adithyasunil26/2-stage-OTA/Report.pdf

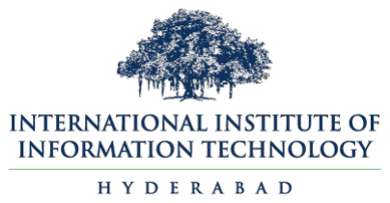
[picture p1: figure]

# ANALOG IC DESIGN

## COURSE PROJECT

## Adithya Sunil Edakkadan

2019102005

# Contents

1 Design Specification | 1
2 Architecture and hand calculations | 2
3 Simulations | 7
4 Layout | 20

5 Design example | 33
6 Results | 37

## CHAPTER 1

# DESIGN SPECIFICATION

### 1.1 DESIGN SPECIFICATIONS

The given design specifications are as follows:

- DC gain ≥ 80 dB
- Unity gain frequency ≥ 10 MHz
- Output voltage swing ≥ 1Vpp
- Slew rate ≥ 100 V/µs
- Phase Margin ≥ 65◦
- Input referred noise (Thermal only) = 10nv/√ Hz
- Input Common mode voltage = 0.9 V
- Output load capacitance = 1 pF
- VDD ≤ 1.8 V
- Minimum power consumption

### 1.2 SPECIFICATION DESCRIPTION

The given specifications require the amplifier to have a large gain of 80 dB or greater, a unity gain frequency greater than or equal to 10 MHz and an output voltage swing of 1 V. The slew rate of the amplifier must be greater than or equal to 100 V/µs and phase margin greater than 65◦
. The input referred
noise due to thermal noise must 10 nV/√
Hz. The input common mode voltage is 0.9 V, output load capacitance is 1 pF and the source voltage is 1.8 V. The specifications also require the power consumption to be minimized while meeting the other requirements.

## CHAPTER 2

# ARCHITECTURE AND HAND

# CALCULATIONS

### 2.1 ARCHITECTURE COMPARISON AND SELECTION

To meet the specifications for high gain, high output swing, minimal power dissipation and low noise performance, a 2 stage op-amp topology is used. The first stage must produce very high gain while the second stage produces high output swing. The telescopic cascode op-amp architecture offers high gain due to the increased output resistance and improved noise performance for lower power consumption. However,the output swing is diminished. The folded-cascode architecture in comparison offers higher swing at the cost of higher power consumption. Hence, the chosen structure for the first stage is the telescopic op-amp as it offers high gain while consuming less power. The second stage is a common source amplifier stage which improves the output swing.

### 2.2 SCHEMATIC

The schematic of the selected architecture is as shown in Fig. 2.1.

### 2.3 DESIGN PROCEDURE AND CALCULATIONS

The transistor parameters are as summarized in Table 2.1. These values are taken from the TSMC 180nm wafer tests sheet found here. (http://www.ee.iitm.ac.in/~nagendra/cadinfo/tsmc018_info.txt)

TABLE 2.1
Table showing design parameters
Parameter | N-Channel | P-Channel
Vth (V) | 0.51 | -0.51
µCox (µA/V ² ) 2 | 175.4 | -35.6

The design process followed is as follows.

VDD = 1.8V

The phase margin is given by Eq. (2.1).

ϕM = ±180◦−Arg[A(jω)F(jω)] = ±180◦−tan⁻¹

ω
|p1|
−tan⁻¹
ω
|p2|
−tan⁻¹
ω
|z1|
(2.1)

CHAPTER 2 – ARCHITECTURE AND HAND CALCULATIONS

M3 | M4
M1 | M2
M5 | M6
M7 | M8 Vdd
M10 | M9

M12

M11

I

ref | CC

RC

Vin- | Vin+ Vb1

Vb2

Vout

FIGURE 2.1
Schematic of the selected 2-stage op-amp structure

Considering the zero is 10 times higher than gain bandwidth and phase margin of 80◦

80◦ = 180◦ − tan⁻¹

[AV (0)] − tan⁻¹

GB
|p2|
− tan⁻¹
(0.1)

For large AV (0) the equation can be simplified to

4.2894◦ = tan⁻¹

GB
|p2|

Solving for |p2| as follows

|p2| =

GB
tan(4.2894◦) = 13.3 · GB

The requirement for Miller capacitance (CC) value for such pole placement is given by Eq. (2.2)

CC >

13.3
10
CL | (2.2)

So the capacitance must be chosen such that

CC > 1.33 pF

CC is selected to be 2pF. The slew rate required is > 100 V /µs. A slew rate of 200 V /µs is selected for the OTA. The tail current I9 is given by Eq. (2.3).

I9 = SR · CC | (2.3)

CHAPTER 2 – ARCHITECTURE AND HAND CALCULATIONS

I9 = 200 × 10⁶ × 2 × 10⁻¹²

I9 = 400 µA

Assuming the output of the telescopic stage is biased at VDD 2 which is 0.9 V the equations for the saturation drain source voltage are as follows.

VSDsat6

+ VSDsat8

= 0.375

VDSsat4

+ VDSsat2

+ VDSsat9

= 0.375

Considering M1, M2, M3 and M4 to be identical and M5, M6, M7 and M8 to be identical

VSDsat5−8

= 0.1875

VDSsat1−4

= 0.1275

The transconductance of a transistor is given by Eq. (2.4).

gm =

2ID

VDSsat

(2.4)

We have

gm1−4 =

400×10⁻⁶
0.1275 = 3.137 mS

gm5−8 =

400×10⁻⁶
0.1875 = 2.133 mS

The relation between gm and ID as given in Eq. (2.5) can be used to find the W
L

of the transistors.

gm =

s
2µCox
W
L
ID | (2.5)

We have
W
L

1−4

= 70.1309 ≈ 71
W
L

5−8

= 159.75 ≈ 160

For M9 the W
L

ratio can be taken as double that of M1 as the current is double.
W
L

9

= 142

For the 2nd stage of the OTA, the design parameters are derives as follows.

gm11 = 1.33
CL
CL
gm1−4 = 2.086 mS
W
L

11

=

W
L

5−8

gm11

gm5−8

= 160
2.086

2.133
= 156.47 ≈ 157

I11 =

g

2m11
2µpCox(
W

L )
11

= 194.63 ≈ 195 µA
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
≈ 70

For cancelling the non-dominant pole using a nulling resistor RC,

RC =

CC +CL
gm11CC

=

1×10⁻¹²+2×10⁻¹²
2.086×10⁻³×2×10⁻¹² = 719.08Ω

CHAPTER 2 – ARCHITECTURE AND HAND CALCULATIONS

Now, the specifications of the designed amplifier can be calculated. The gain of the 2 stage structure will the product of the individual stages.

Av = Av1Av2

For finding the gain of the telescopic cascode stage, gds of a transistor is given by Eq. (2.6).

gds = λID | (2.6)

The λN and λP can be experimentally found to be 0.018 V

−1
and 0.015 V

−1
| . The gds and respective rds
values are as follows.

gds1−4 = λN ID1−4 = 0.018 × 200 × 10⁻⁶ = 3.6 µS

rds1−4 =

1
gds1−4

= 277.78 kΩ

gds5−8 = λN ID5−8 = 0.015 × 200 × 10⁻⁶ = 3 µS

rds5−8 =

1
gds5−8

= 333.33 kΩ

The output resistance of the stage rout is given by

rout = ru||rd

rd = gm1−4

r

2
ds1−4

= 236.9 MΩ

ru = gm5−8

r

2
ds5−8

= 242.1 MΩ

rout = 119.7 MΩ

The DC gain of the telescopic stage is as follows.

Av1 = gm1
rout = 375499

Similarly, the gain of the common source stage is given by

Av2 =

gm11

ID11 (λN +λP )

gm11 = 13.3 · gm1−4

CL
CC

Av2 =

gm11
ID11 (λN +λP ) ≈ 324

Hence, the overall gain (Av = Av1Av2
) is well over 100dB.

The gain bandwidth can be calculated as follows

UGB =

gm1
Cc

= 1.57 GHz

The power consumption of the OTA is given by

P = ItotVDD

where Itot will be given by

Itot = I9 + I11

P = (I9 + I11) · VDD = (400µ + 195µ) · 1.8 = 1.071 mA

CHAPTER 2 – ARCHITECTURE AND HAND CALCULATIONS

### 2.4 TABULATING CALCULATED VALUE OF DESIGN PARAMETERS

Table 2.2 shows the design parameters derived in the previous section.

TABLE 2.2
Table showing design parameters
Parameter | Calculated value
W L 1−4 | 71
W L 5−8 | 160
W L 9 | 142
W L 10 | 142
W L 11 | 157
W L 12 | 70
CC (pF) | 2
RC (kΩ) | 0.719

### 2.5 TABULATING CALCULATED SPECIFICATIONS

Table 2.2 shows the calculated specifications as per the design parameters derived in the previous sections.

TABLE 2.3
Table showing calculated specifications
Specification | Calculated Value
DC gain (dB) | >100
Unity gain bandwidth (GHz) | 1.57
Phase margin | 80◦
Slew rate (V /µs) | 200
Power (mW) | 1.071

## CHAPTER 3

# SIMULATIONS

### 3.1 NETLIST

The netlist for the designed 2 stage OTA is as follows.

* T e l e s c o p i c
. i n c l u d e TSMC_180nm . t x t

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

. param width_1234 ={0.36*71 u} . param width_5678 ={0.36*160 u} . param width_910 ={0.36*142 u} . param width_11 ={0.36*157 u} . param width_12 ={0.36*70 u}

. g l o b a l gnd vdd

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

* T r a n s i e n t and AC
vi np i n p gnd dc 0 . 9 ac 0 . 0 1m s i n ( 0 . 9 0 . 0 1m 10k 0 0 0) vi nn i n n gnd dc 0 . 9 ac −0.01m s i n ( 0 . 9 −0.01m 10k 0 0 0)

* Slew Rate
* vi np i n p gnd p u l s e ( 1 . 8 0 −1n 100 p 100 p 500 n 1u )

* O f f s e t
* vi np i n p gnd 0 . 9

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

* 1 s t s t a g e t e l e s c o p i c s t r u c t u r e ( T r a n s i s t o r s a r e named as p e r t h e s c h e m a t i c diagram shown i n r e p o r t )
M1 | d1 | i n n | d9 | gnd | CMOSN | W={ width_1234 } | L={ l e n g t h }
+ AS={5* width_1234 *LAMBDA} PS={10*LAMBDA+2* width_1234 } AD={5* width_1234 *LAMBDA} PD={10*LAMBDA+2* width_1234 }
M2 | d2 | i n p | d9 | gnd | CMOSN | W={ width_1234 } | L={ l e n g t h }
+ AS={5* width_1234 *LAMBDA} PS={10*LAMBDA+2* width_1234 } AD={5* width_1234 *LAMBDA} PD={10*LAMBDA+2* width_1234 }
M3 | d3 | b1 | d1 | gnd | CMOSN | W={ width_1234 } | L={ l e n g t h }
+ AS={5* width_1234 *LAMBDA} PS={10*LAMBDA+2* width_1234 } AD={5* width_1234 *LAMBDA} PD={10*LAMBDA+2* width_1234 }
M4 | d4 | b1 | d2 | gnd | CMOSN | W={ width_1234 } | L={ l e n g t h }
+ AS={5* width_1234 *LAMBDA} PS={10*LAMBDA+2* width_1234 } AD={5* width_1234 *LAMBDA} PD={10*LAMBDA+2* width_1234 }
M5 | d3 | b2 | d5 | vdd | CMOSP | W={ width_5678 } | L={ l e n g t h }
+ AS={5* width_5678 *LAMBDA} PS={10*LAMBDA+2* width_5678 } AD={5* width_5678 *LAMBDA} PD={10*LAMBDA+2* width_5678 }
M6 | d4 | b2 | d6 | vdd | CMOSP | W={ width_5678 } | L={ l e n g t h }
+ AS={5* width_5678 *LAMBDA} PS={10*LAMBDA+2* width_5678 } AD={5* width_5678 *LAMBDA} PD={10*LAMBDA+2* width_5678 }
M7 | d5 | d3 | vdd | vdd | CMOSP | W={ width_5678 } | L={ l e n g t h }
+ AS={5* width_5678 *LAMBDA} PS={10*LAMBDA+2* width_5678 } AD={5* width_5678 *LAMBDA} PD={10*LAMBDA+2* width_5678 }
M8 | d6 | d3 | vdd | vdd | CMOSP | W={ width_5678 } | L={ l e n g t h }
+ AS={5* width_5678 *LAMBDA} PS={10*LAMBDA+2* width_5678 } AD={5* width_5678 *LAMBDA} PD={10*LAMBDA+2* width_5678 }

* 2nd s t a g e common s o u r c e s t r u c t u r e
M9 | d9 | r e f | gnd | gnd | CMOSN | W={ width_910 } | L={ l e n g t h }
+ AS={5* width_910 *LAMBDA} PS={10*LAMBDA+2* width_910 } AD={5* width_910 *LAMBDA} PD={10*LAMBDA+2* width_910 }
M10 | r e f | r e f | gnd | gnd | CMOSN | W={ width_910 } | L={ l e n g t h }
+ AS={5* width_910 *LAMBDA} PS={10*LAMBDA+2* width_910 } AD={5* width_910 *LAMBDA} PD={10*LAMBDA+2* width_910 }

CHAPTER 3 – SIMULATIONS

M11 | o u t | d4 | vdd | vdd | CMOSP | W={ width_11 } | L={ l e n g t h }
+ AS={5* width_11 *LAMBDA} PS={10*LAMBDA+2* width_11 } AD={5* width_11 *LAMBDA} PD={10*LAMBDA+2* width_11 }
M12 | o u t | r e f | gnd | gnd | CMOSN | W={ width_12 } | L={ l e n g t h }
+ AS={5* width_12 *LAMBDA} PS={10*LAMBDA+2* width_12 } AD={5* width_12 *LAMBDA} PD={10*LAMBDA+2* width_12 }

* A n a l y s i s
* . t r a n 1u 1m
* . ac dec 10 1 500Meg
. n o i s e v ( o u t ) vin p dec 100 1 500MEG

. c o n t r o l
run

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

* P l o t s

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

* Gain magnitude and phase
* p l o t ( v ( o u t ) ) / ( v ( i n p ) − v ( i n n ) )
* p l o t 180 / PI * phase ( v ( o u t ) / ( v ( i n p ) − v ( i n n ) ) )
* p l o t ( db ( v ( o u t )) − db ( v ( i n p ) − v ( i n n ) ) ) 18 0/ PI * phase ( v ( o u t ) / ( v ( i n p ) − v ( i n n ) ) )

. endc

### 3.2 TABULATING DESIGN PARAMETERS

Table 6.2 shows the calculated value of design parameters alongside the values used in simulation.

TABLE 3.1
Table showing design parameters
Parameter | Calculated Value | Simulated Value
W L 1−4 | 71 | 71
W L 5−8 | 160 | 160
W L 9 | 142 | 142
W L 10 | 142 | 142
W L 11 | 157 | 157
W L 12 | 70 | 70
CC (pF) | 2 | 2
RC (kΩ) | 0.719 | 1
Iref (µA) | 400 | 400

CHAPTER 3 – SIMULATIONS

### 3.3 OPERATING POINT

The DC operating point analysis is run with the OTA in unity gain feedback mode. Fig. 3.1 shows the results obtained and Fig. 3.2 shows the schematic for the OTA in unity gain feedback mode with labelled nodes.

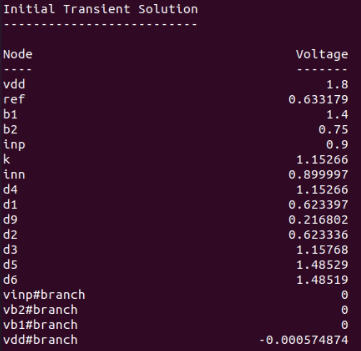
[picture p2: figure]

FIGURE 3.1
DC operating points

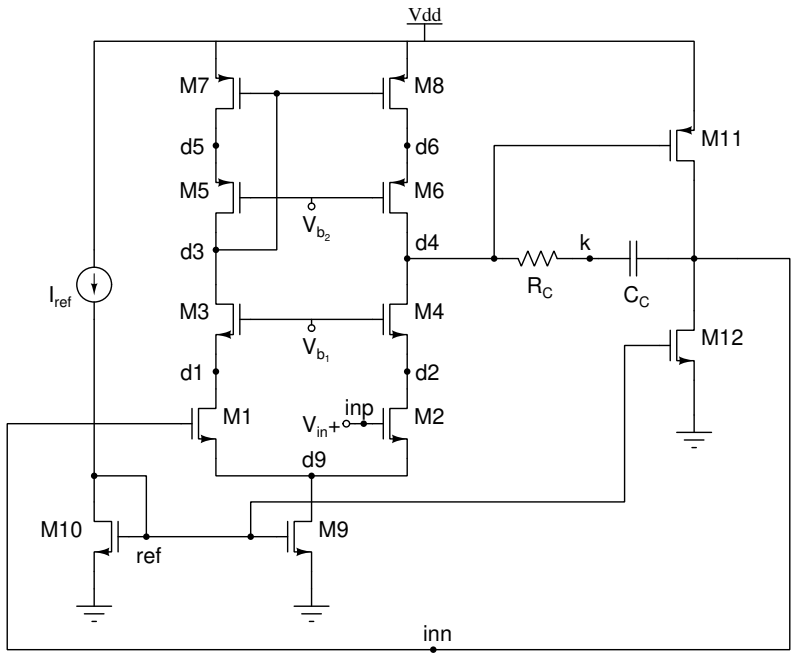
[picture p3: figure]
Vdd; ref; Vin+; inn; inp

FIGURE 3.2
Schematic for unity gain configuration with labelled nodes

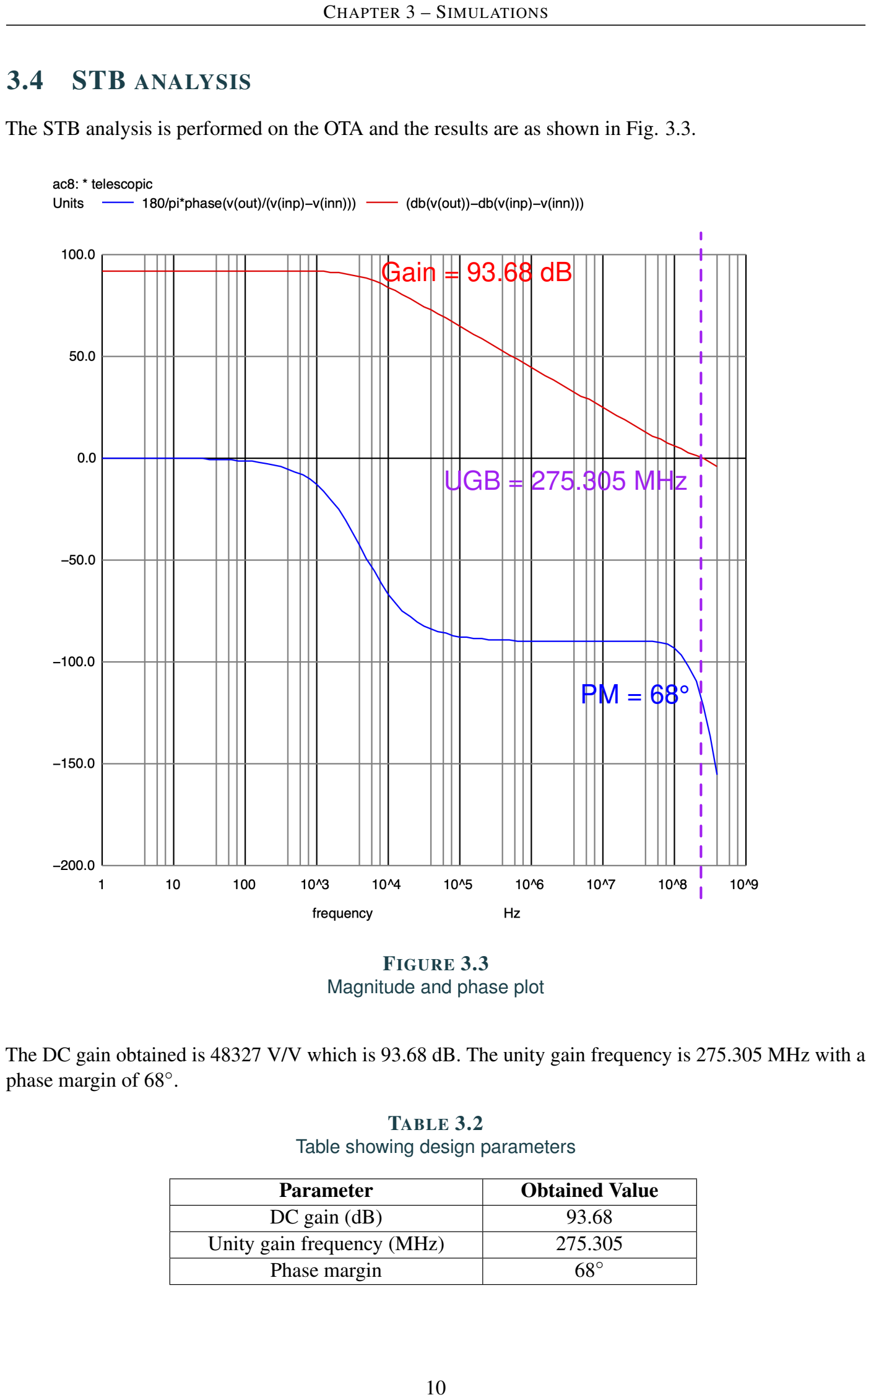
[picture p4: page 13]

CHAPTER 3 – SIMULATIONS

### 3.4 STB ANALYSIS

The STB analysis is performed on the OTA and the results are as shown in Fig. 3.3.

UGB = 275.305 MHz

Gain = 93.68 dB

PM = 68°

FIGURE 3.3
Magnitude and phase plot

The DC gain obtained is 48327 V/V which is 93.68 dB. The unity gain frequency is 275.305 MHz with a phase margin of 68◦

TABLE 3.2
Table showing design parameters
Parameter | Obtained Value
DC gain (dB) | 93.68
Unity gain frequency (MHz) | 275.305
Phase margin | 68◦

CHAPTER 3 – SIMULATIONS

### 3.5 SLEW RATE

With the OTA in unity gain feedback mode, a positive step from 0 to 1.8V with a rise time of 100ps is applied. Fig. 3.4 shows the slewing region.

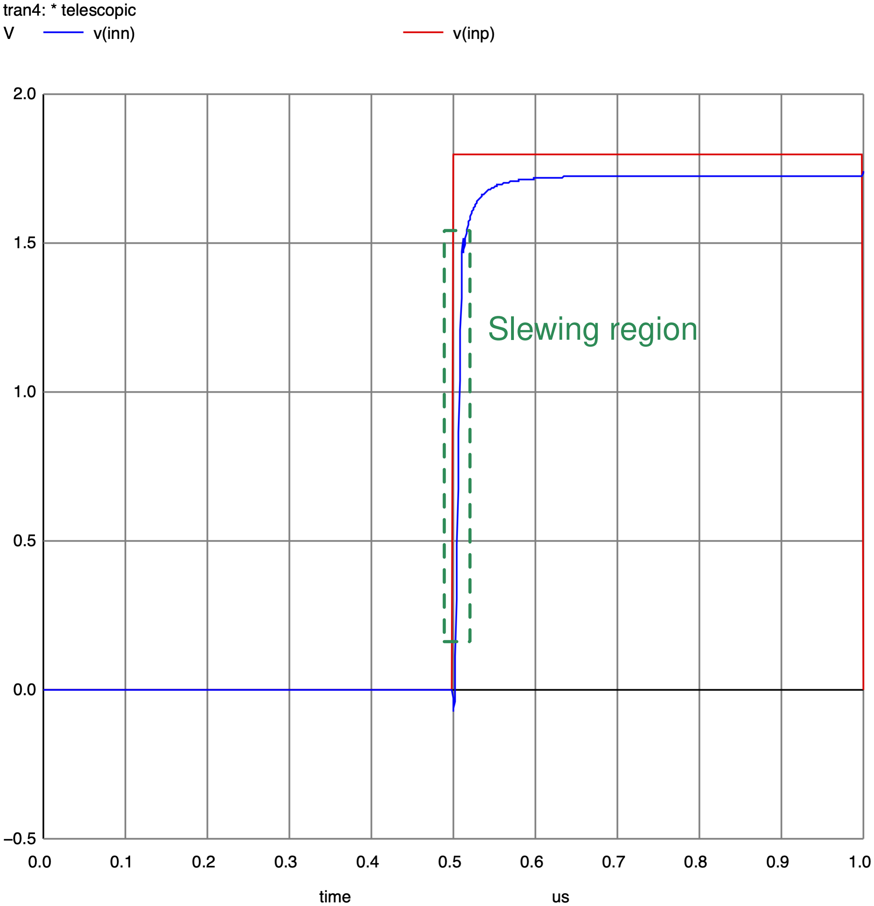
[picture p5: figure]
Slewing region

FIGURE 3.4
Plot showing slewing

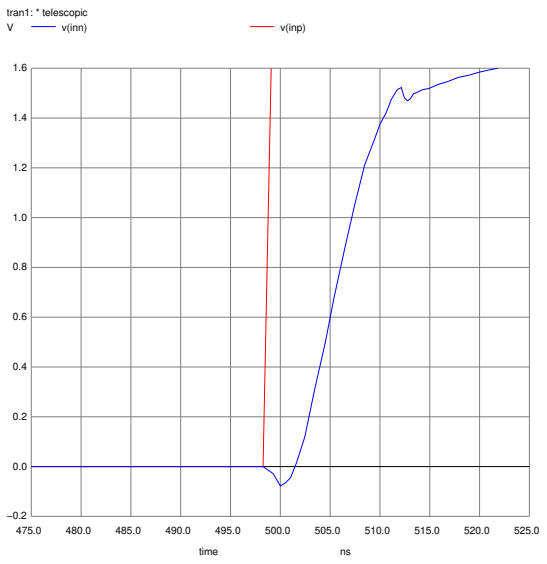
[picture p6: figure]
time; tran1: * telescopic; v(inn); v(inp)

FIGURE 3.5
Plot showing slewing

From zoomed in version of plot shown in Fig. 3.5, the following values of points are obtained of the highest slope region.

x0 = 5.08435e-07, y0 = 1.2

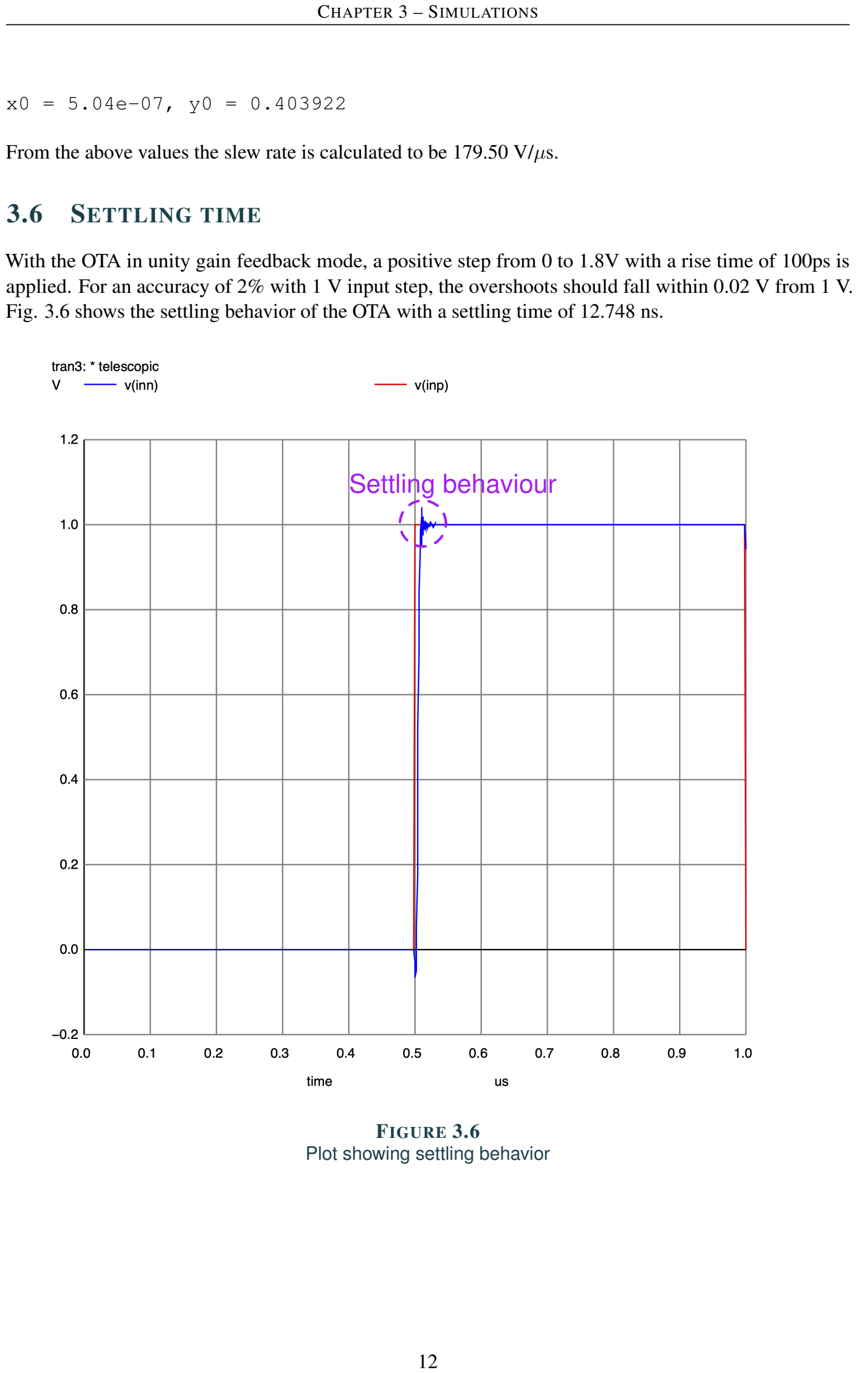
[picture p7: page 15]

CHAPTER 3 – SIMULATIONS

x0 = 5.04e-07, y0 = 0.403922

From the above values the slew rate is calculated to be 179.50 V/µs.

### 3.6 SETTLING TIME

With the OTA in unity gain feedback mode, a positive step from 0 to 1.8V with a rise time of 100ps is applied. For an accuracy of 2% with 1 V input step, the overshoots should fall within 0.02 V from 1 V. Fig. 3.6 shows the settling behavior of the OTA with a settling time of 12.748 ns.

## Settling behaviour

FIGURE 3.6
Plot showing settling behavior

CHAPTER 3 – SIMULATIONS

### 3.7 SYSTEMATIC OFFSET

With the OTA in unity gain feedback mode, the systematic offset value is measured and reported using dc analysis. Fig. 3.7 shows the node voltage on the schematic and the offset of 3.45 µV.

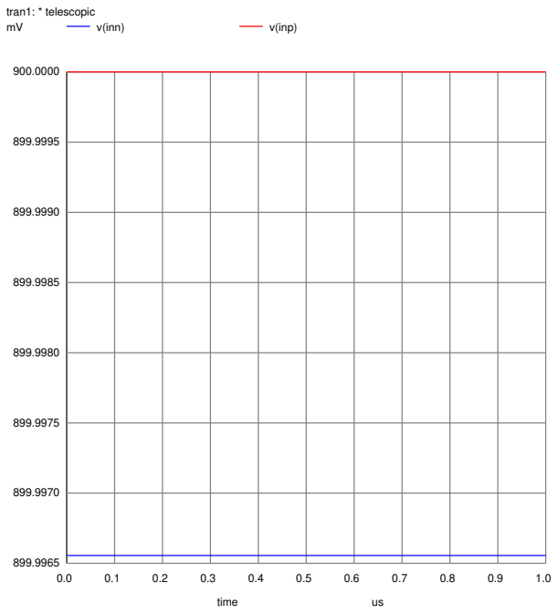
[picture p8: figure]
time; tran1: * telescopic; v(inn); v(inp)

FIGURE 3.7
Plot showing systemic offset

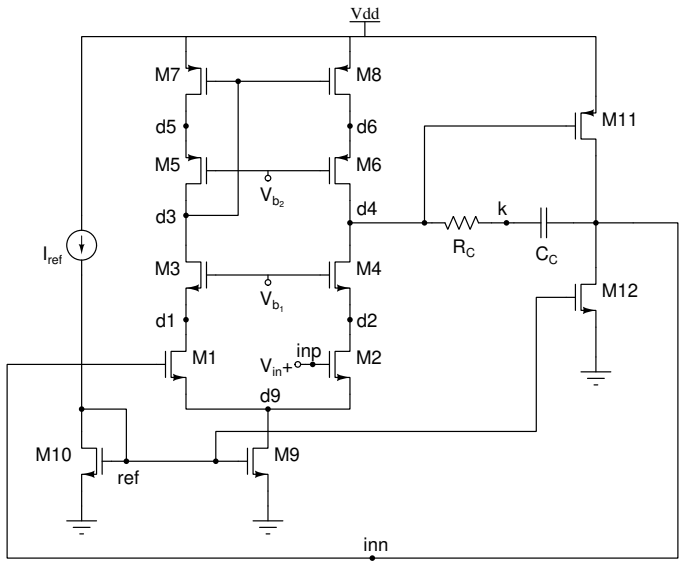
[picture p9: figure]
Vdd; ref; Vin+; inn; inp

FIGURE 3.8
Schematic for unity gain configuration with labelled nodes

## 3.8 NOISE

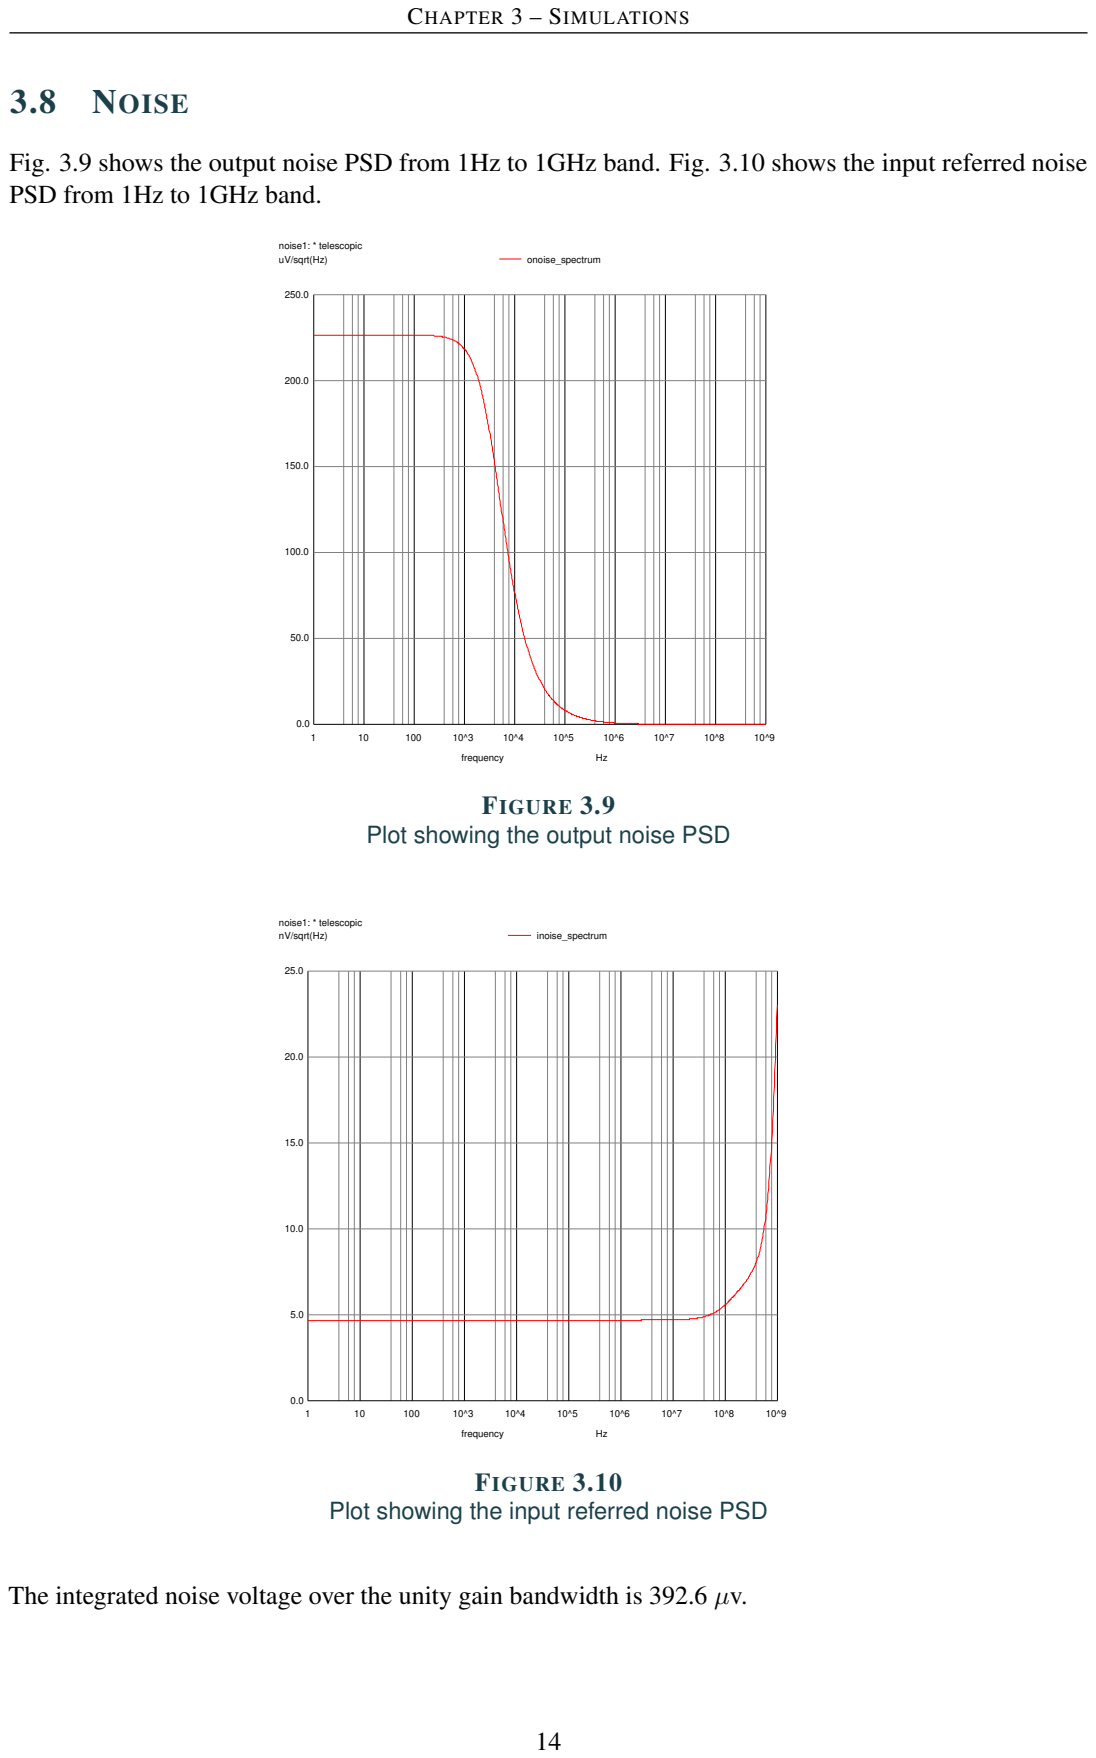
[picture p10: page 17]
CHAPTER 3 – SIMULATIONS; frequency; noise1: * telescopic; uV/sqrt(Hz); onoise_spectrum; FIGURE 3.9; nV/sqrt(Hz); inoise_spectrum; FIGURE 3.10

Fig. 3.9 shows the output noise PSD from 1Hz to 1GHz band. Fig. 3.10 shows the input referred noise
PSD from 1Hz to 1GHz band.

Plot showing the output noise PSD

Plot showing the input referred noise PSD

The integrated noise voltage over the unity gain bandwidth is 392.6 µv.

CHAPTER 3 – SIMULATIONS

## 3.9 CMRR

Common mode rejection ratio (CMRR) quantifies the ability of the device to reject common-mode signals. Fig. 3.11 shows the open loop CM gain of the OTA.

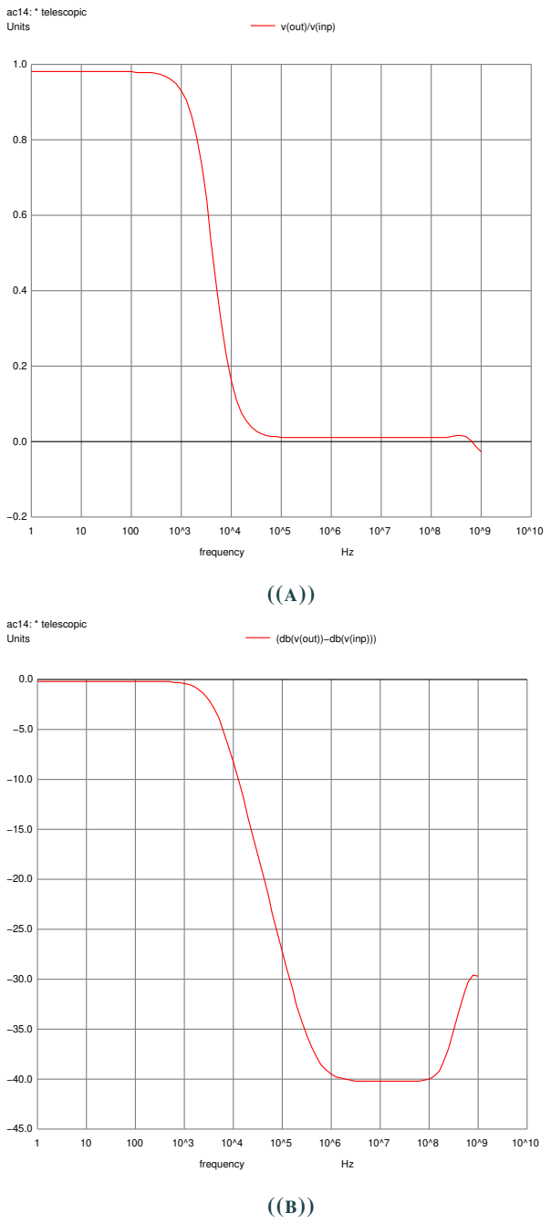
[picture p11: figure]
frequency; ac14: * telescopic; Units; v(out)/v(inp); (db(v(out))−db(v(inp)))

FIGURE 3.11
Common mode gain: (a) V/V and (b) dB

The CM gain (ACM) of the OTA is found to be 0.98 V/V. The differential gain (Ad) of the device is 40017

CHAPTER 3 – SIMULATIONS

V/V. Hence, the CMRR of the OTA is given by Ad
ACM

which is equal to 40833.7 which is equivalent to 92.22 dB.

## 3.10 PSRR

The power supply rejection ratio (PSRR) is used to quantify the ability of the device to reject variations in power supply. The PSRR simulation is performed by adding a small signal component only on the voltage supply of the OTA. Fig. 3.12 shows the results obtained.

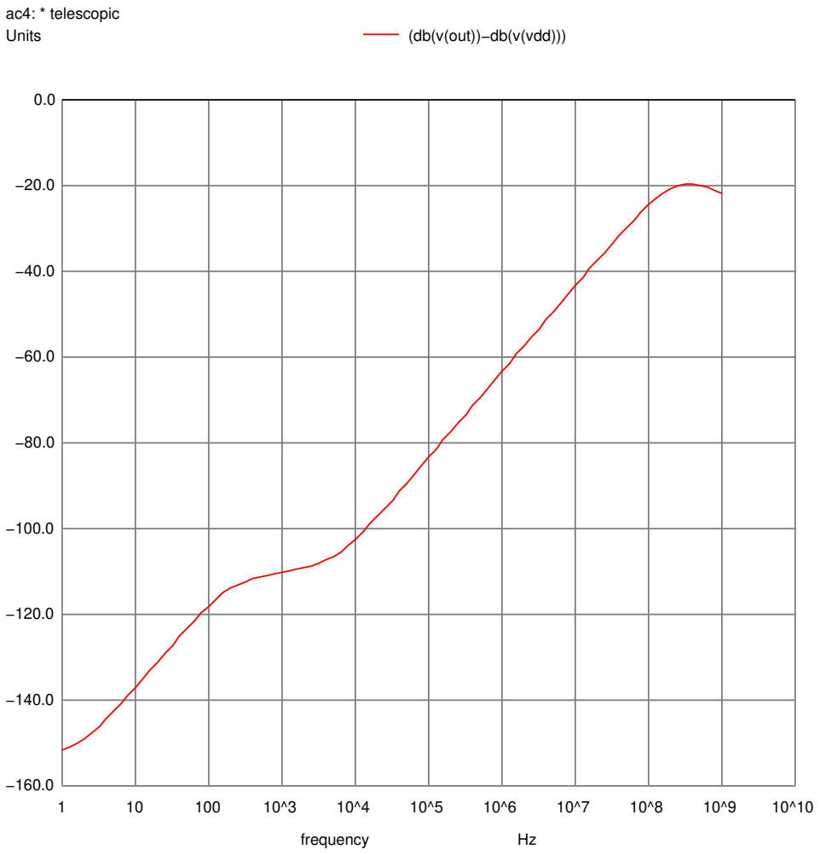
[picture p12: figure]
frequency; ac4: * telescopic; Units; (db(v(out))−db(v(vdd)))

FIGURE 3.12
Gain due to power supply

The PSRR of the OTA is -151.8 dB which means the OTA highly diminishes changes in supply voltage and hence, is resilient to variations in power supply.

CHAPTER 3 – SIMULATIONS

### 3.11 INPUT COMMON MODE RANGE

The input common mode voltage is sweeped in the unity gain configuration. Fig. 3.13 shows the results

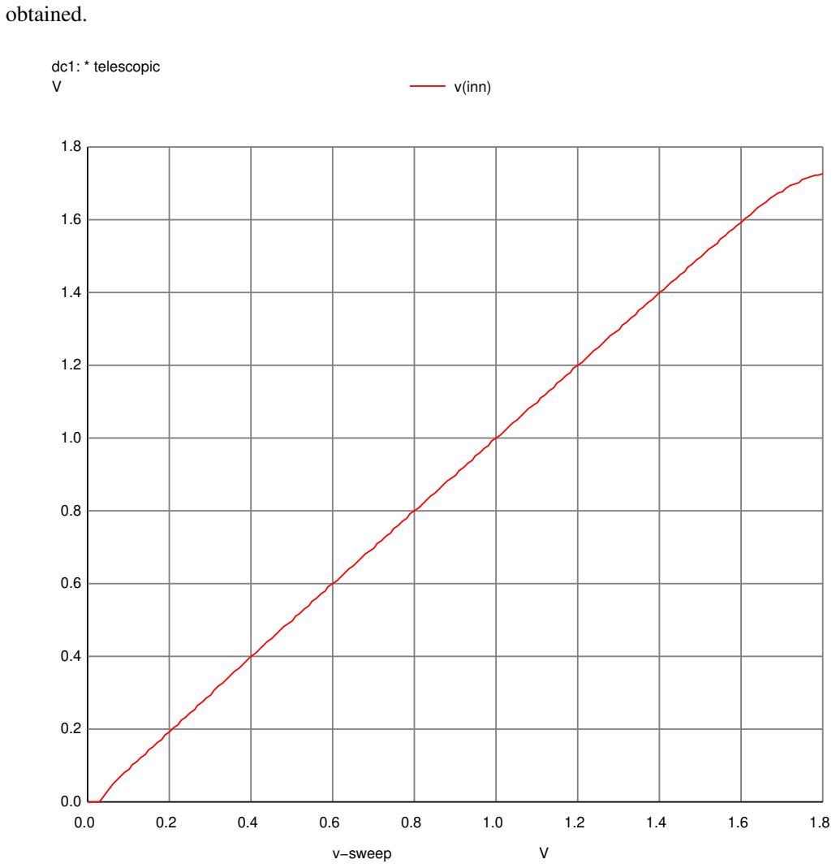
[picture p13: figure]
obtained.; v−sweep; dc1: * telescopic; v(inn)

FIGURE 3.13
Variation of output voltage with input common mode voltage

The maximum input common mode range is 0.4 V - 1.45 V.

CHAPTER 3 – SIMULATIONS

### 3.12 CLOSED LOOP GAIN

With the OTA in unity gain feedback mode, ac analysis is performed. Fig. 3.14 shows the results obtained.

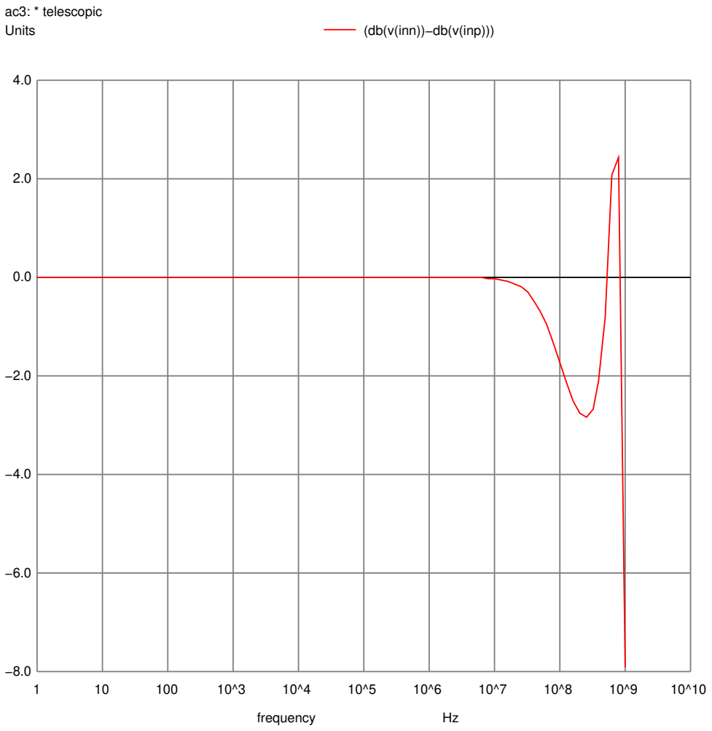
[picture p14: figure]
frequency; ac3: * telescopic; Units; (db(v(inn))−db(v(inp)))

FIGURE 3.14
Closed loop gain

The closed loop gain is 0dB or 1 V/V with a -3dB frequency of 0.899 GHz.

CHAPTER 3 – SIMULATIONS

### 3.13 CLOSED LOOP TRANSIENT ANALYSIS

With the OTA in unity gain feedback mode, a sinusoidal signal of 10KHz frequency is applied for maximum signal swing at the output without distortion Fig. 3.15 shows the results obtained.

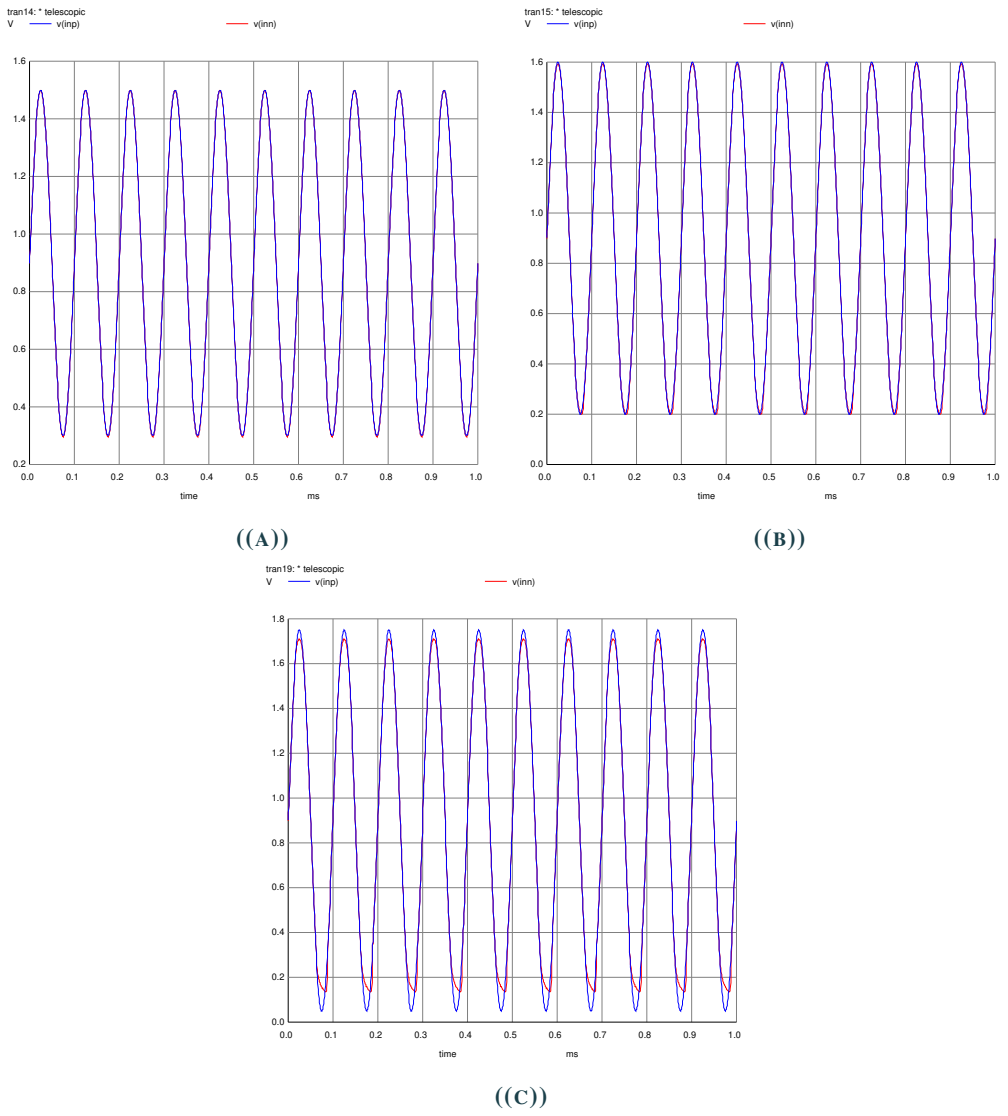
[picture p15: figure]
time; tran14: * telescopic; v(inp); v(inn); tran15: * telescopic; tran19: * telescopic

FIGURE 3.15
Closed loop transient analysis plots: (a) Output swing of 1.2 V, (b) Output swing of 1.4 V and (c) Output swing of 1.7 V

Output swing of 1.2 V can be obtained with THD less than 0.3% while a swing of 1.4 V increases the THD to 1.2%. Output swing of upto 1.7 V can be obtained with a THD of 5.5%.

### 3.14 POWER CONSUMPTION

The average value of current drawn by the OTA from supply in simulation is 569.129 µA and the total power consumption is 1.024 mW.

## CHAPTER 4

# LAYOUT

### 4.1 LAYOUT

The proposed OTA has been implemented in 180nm CMOS technology and occupies an area of 65.16 µm × 23.58 µm. Fig. 4.1 shows the layout of the OTA.

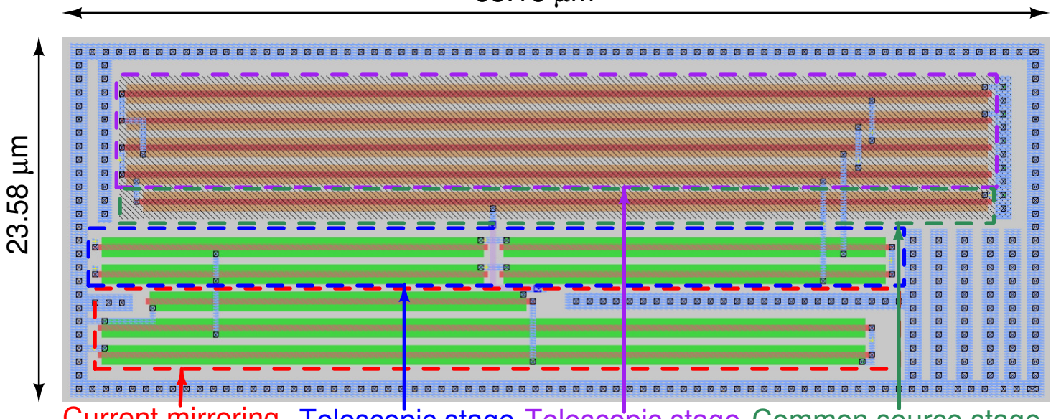
[picture p16: figure]

### Current mirroring transistors

### Telescopic stage NMOS

### Telescopic stage PMOS

### Common source stage PMOS

65.16 µm

FIGURE 4.1
Layout of implemented OTA

### 4.2 POST-LAYOUT SIMULATIONS

The extracted netlist for the layout is as follows.

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

. o p t i o n s c a l e =0.09 u

M1000 d4 b1 d2 gnd CMOSN w=284 l =4 + ad =1420 pd =578 as =2840 ps =1156 M1001 d4 b2 d6 vdd CMOSP w=640 l =4 + ad =3200 pd =1290 as =6400 ps =2580 M1002 d6 d3 vdd vdd CMOSP w=640 l =4 + ad =0 pd=0 as =9540 ps =3846
M1003 d3 b1 d1 gnd CMOSN w=284 l =4 + ad =1420 pd =578 as =2840 ps =1156 M1004 d9 i n p d2 gnd CMOSN w=284 l =4

CHAPTER 4 – LAYOUT

+ ad =5680 pd =2302 as =0 ps =0
M1005 r e f r e f gnd gnd CMOSN w=568 l =4 + ad =2840 pd =1146 as =7080 ps =2862 M1006 d3 b2 d5 vdd CMOSP w=640 l =4
+ ad =3200 pd =1290 as =6400 ps =2580 M1007 d9 i n n d1 gnd CMOSN w=284 l =4 + ad =0 pd=0 as =0 ps =0
M1008 d5 d3 vdd vdd CMOSP w=640 l =4 + ad =0 pd=0 as =0 ps =0
M1009 o u t d4 vdd vdd CMOSP w=628 l =4 + ad =3140 pd =1266 as =0 ps =0
M1010 gnd r e f o u t gnd CMOSN w=280 l =4 + ad =0 pd=0 as =1400 ps =570
M1011 d9 r e f gnd gnd CMOSN w=568 l =4 + ad =0 pd=0 as =0 ps =0
C0 d1 d3 0 . 0 2 fF
C1 o u t d4 0 . 0 2 fF
C2 d6 d5 0 . 1 3 fF
C3 d9 o u t 0 . 0 2 fF
C4 b1 d3 0 . 1 0 fF
C5 o u t d3 0 . 0 2 fF
C6 d6 b2 0 . 1 0 fF
C7 d6 d3 0 . 1 5 fF
C8 r e f o u t 0 . 0 3 fF
C9 d5 d3 0 . 1 2 fF
C10 d2 o u t 0 . 0 9 fF
C11 vdd o u t 0 . 0 2 fF
C12 d9 i n p 0 . 1 0 fF
C13 d4 d3 0 . 1 4 fF
C14 d1 o u t 0 . 1 1 fF
C15 vdd d6 0 . 0 4 fF
C16 b2 d3 0 . 2 1 fF
C17 gnd d4 0 . 0 2 fF
C18 vdd d5 0 . 0 6 fF
C19 d9 r e f 0 . 2 3 fF
C20 gnd d9 0 . 0 4 fF
C21 d2 d4 0 . 0 2 fF
C22 vdd d4 0 . 2 1 fF
C23 gnd b2 0 . 1 6 fF
C24 d9 d2 0 . 0 2 fF
C25 gnd i n p 0 . 0 8 fF
C26 d1 d4 0 . 0 2 fF
C27 vdd b2 0 . 2 3 fF
C28 gnd d3 0 . 1 6 fF
C29 gnd i n n 0 . 0 8 fF
C30 b1 d4 0 . 2 1 fF
C31 vdd d3 0 . 3 5 fF
C32 gnd r e f 0 . 0 4 fF
C33 d9 gnd 0 . 0 6 fF
C34 i n p gnd 0 . 1 3 fF
C35 i n n gnd 0 . 1 3 fF
C36 r e f gnd 0 . 4 9 fF
C37 d2 gnd 0 . 0 6 fF
C38 d1 gnd 0 . 0 6 fF
C39 b1 gnd 0 . 0 4 fF
C40 o u t gnd 0 . 9 1 fF
C41 d6 gnd 0 . 0 0 fF
C42 d5 gnd 0 . 0 0 fF
C43 d4 gnd 0 . 0 7 fF
C44 b2 gnd 0 . 0 4 fF
C45 d3 gnd 0 . 0 9 fF
C46 gnd gnd 1 5 . 3 6 fF
C47 vdd gnd 7 0 . 8 2 fF

Simulations run in Chapter 3 are repeated on the post-layout extracted netlist as presented in this section.

CHAPTER 4 – LAYOUT

### 4.2.1 OPERATING POINT

The DC operating point analysis is run with the OTA in unity gain feedback mode. Fig. 4.2 shows the results obtained and Fig. 4.3 shows the schematic for the OTA in unity gain feedback mode with labelled nodes.

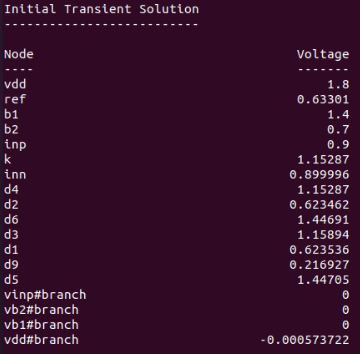
[picture p17: figure]

FIGURE 4.2
DC operating points

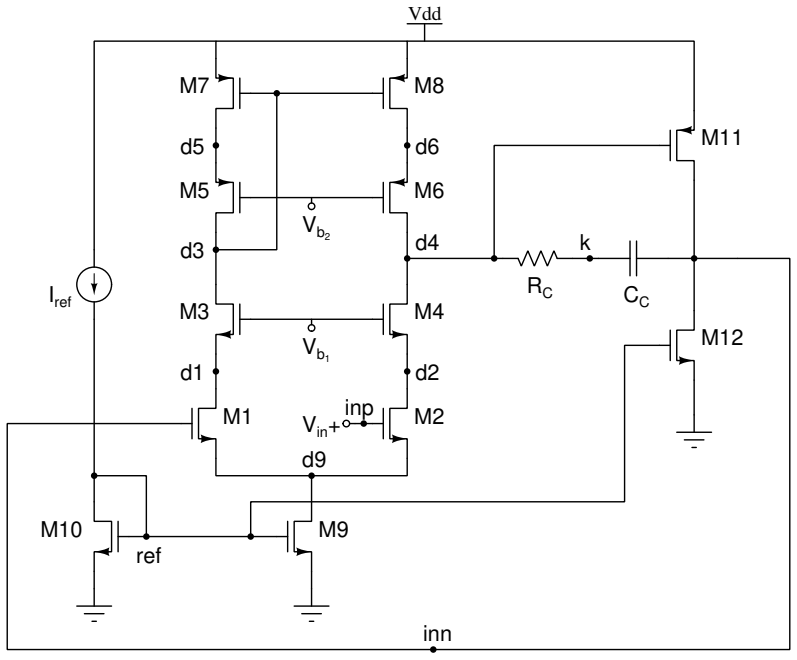
[picture p18: figure]
Vdd; ref; Vin+; inn; inp

FIGURE 4.3
Schematic for unity gain configuration with labelled nodes

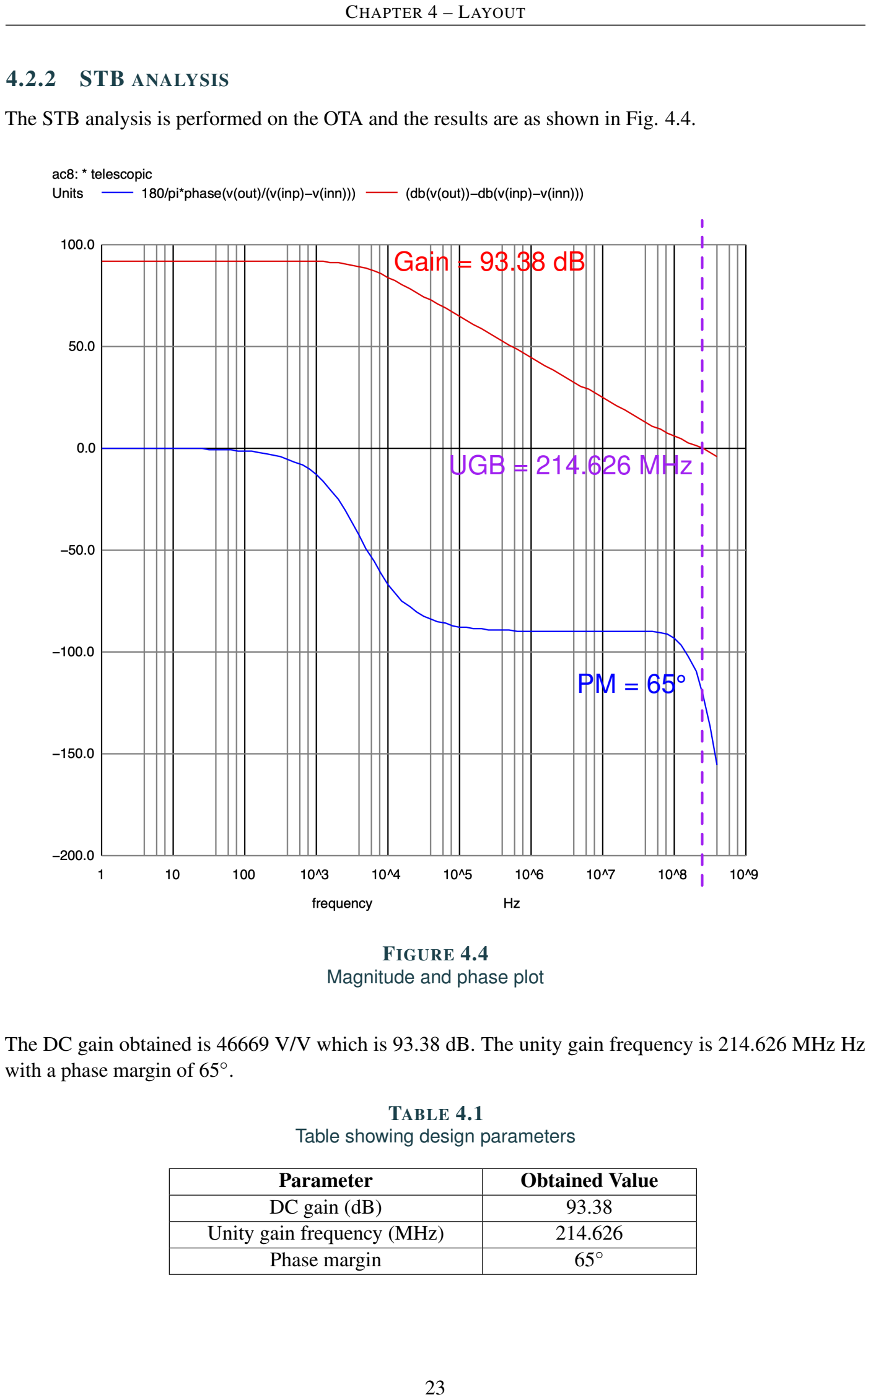
[picture p19: page 26]

CHAPTER 4 – LAYOUT

### 4.2.2 STB ANALYSIS

The STB analysis is performed on the OTA and the results are as shown in Fig. 4.4.

UGB = 214.626 MHz

Gain = 93.38 dB

PM = 65°

FIGURE 4.4
Magnitude and phase plot

The DC gain obtained is 46669 V/V which is 93.38 dB. The unity gain frequency is 214.626 MHz Hz with a phase margin of 65◦

TABLE 4.1
Table showing design parameters
Parameter | Obtained Value
DC gain (dB) | 93.38
Unity gain frequency (MHz) | 214.626
Phase margin | 65◦

CHAPTER 4 – LAYOUT

### 4.2.3 SLEW RATE

With the OTA in unity gain feedback mode, a positive step from 0 to 1.8V with a rise time of 100ps is applied. Fig. 4.5 shows the slewing region.

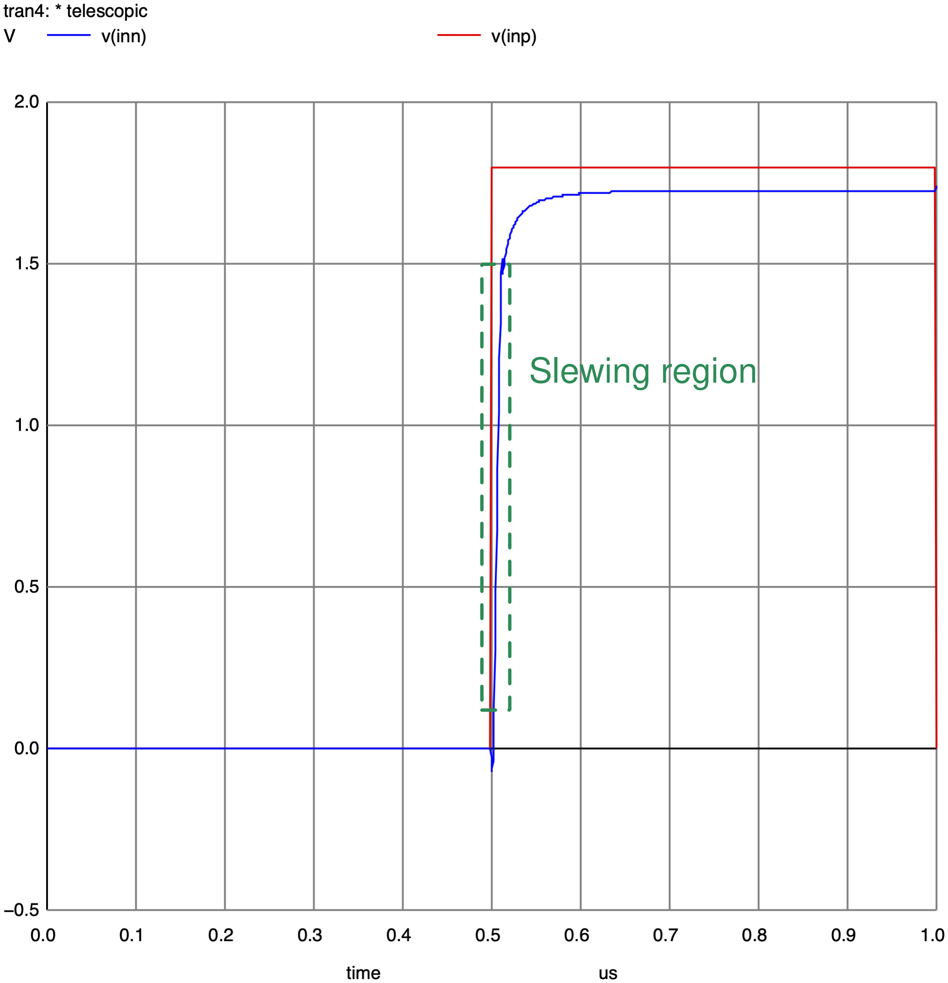
[picture p20: figure]
Slewing region

FIGURE 4.5
Plot showing slewing

time

tran1: * telescopic

490.0 | 495.0 | 500.0 | 505.0 | 510.0 | 515.0 | 520.0

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
V | v(inn) | v(inp)

FIGURE 4.6
Plot showing slewing

From zoomed in version of plot shown in Fig. 4.6, the following values of points are obtained of the highest slope region.

x0 = 5.02839e-07, y0 = 0.329032

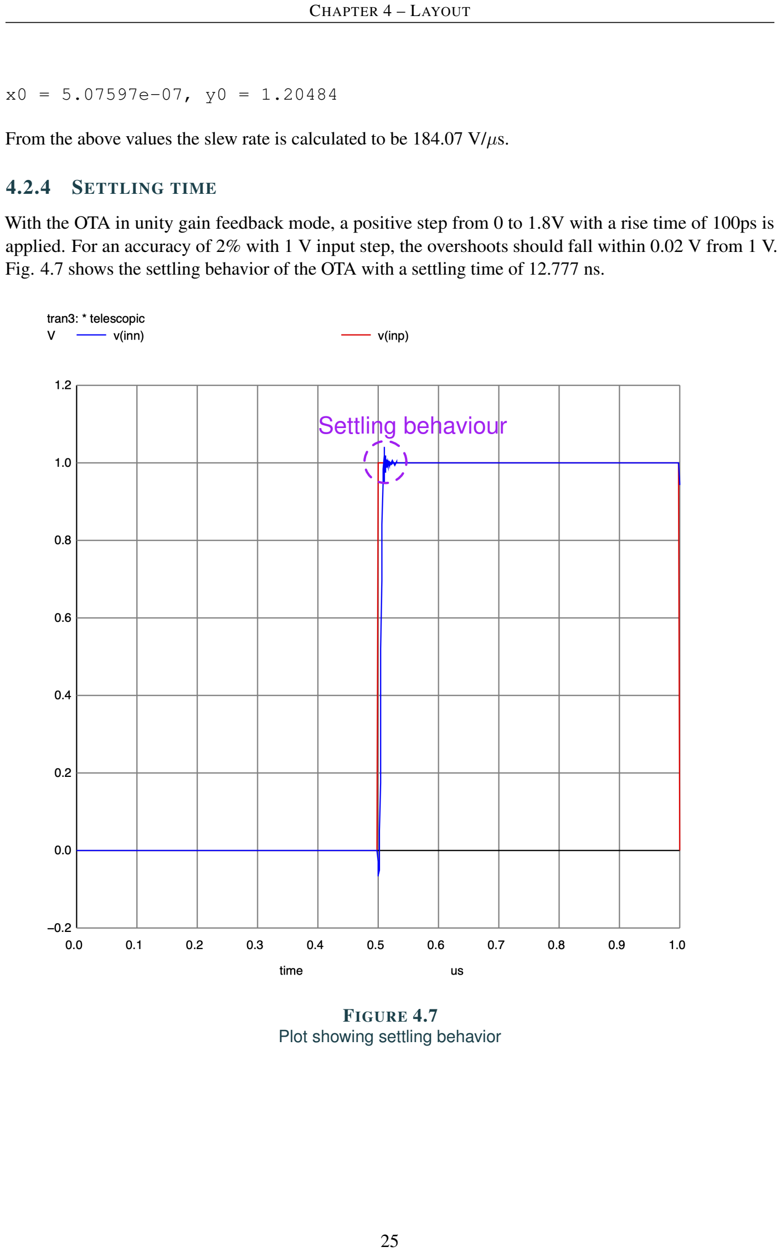
[picture p21: page 28]

CHAPTER 4 – LAYOUT

x0 = 5.07597e-07, y0 = 1.20484

From the above values the slew rate is calculated to be 184.07 V/µs.

### 4.2.4 SETTLING TIME

With the OTA in unity gain feedback mode, a positive step from 0 to 1.8V with a rise time of 100ps is applied. For an accuracy of 2% with 1 V input step, the overshoots should fall within 0.02 V from 1 V. Fig. 4.7 shows the settling behavior of the OTA with a settling time of 12.777 ns.

## Settling behaviour

FIGURE 4.7
Plot showing settling behavior

CHAPTER 4 – LAYOUT

### 4.2.5 SYSTEMATIC OFFSET

With the OTA in unity gain feedback mode, the systematic offset value is measured and reported using dc analysis. Fig. 4.8 shows the node voltage on the schematic and the offset of 4.3 µV.

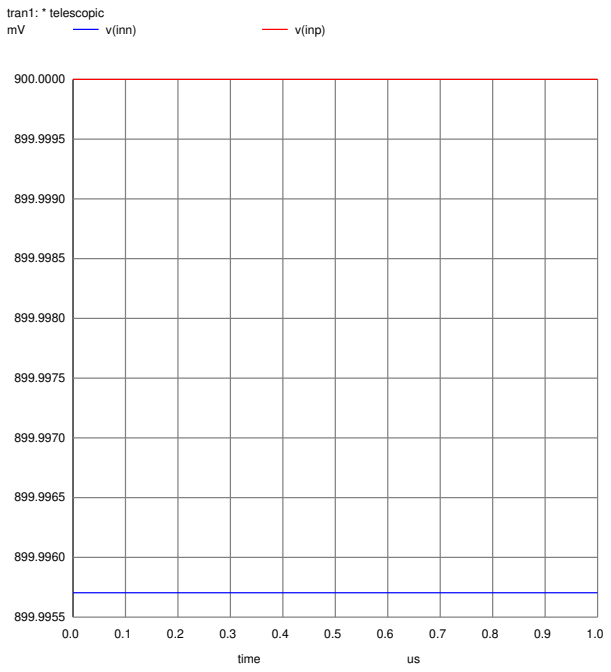
[picture p22: figure]
time; tran1: * telescopic; v(inn); v(inp)

FIGURE 4.8
Plot showing systemic offset

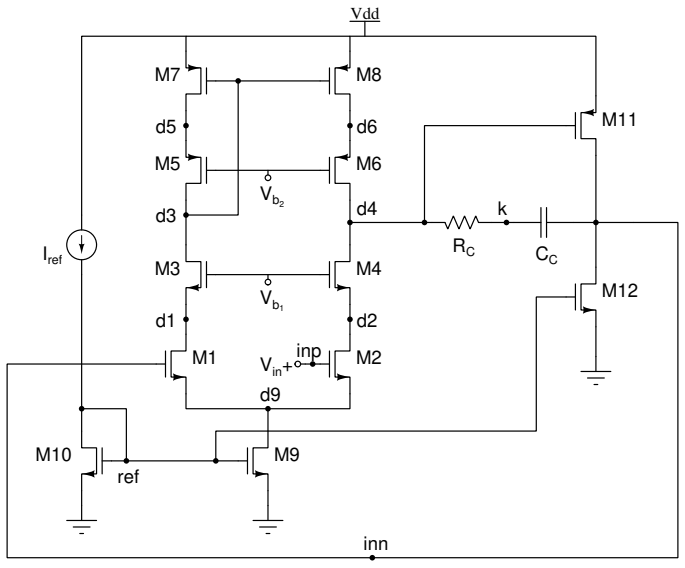
[picture p23: figure]
Vdd; ref; Vin+; inn; inp

FIGURE 4.9
Schematic for unity gain configuration with labelled nodes

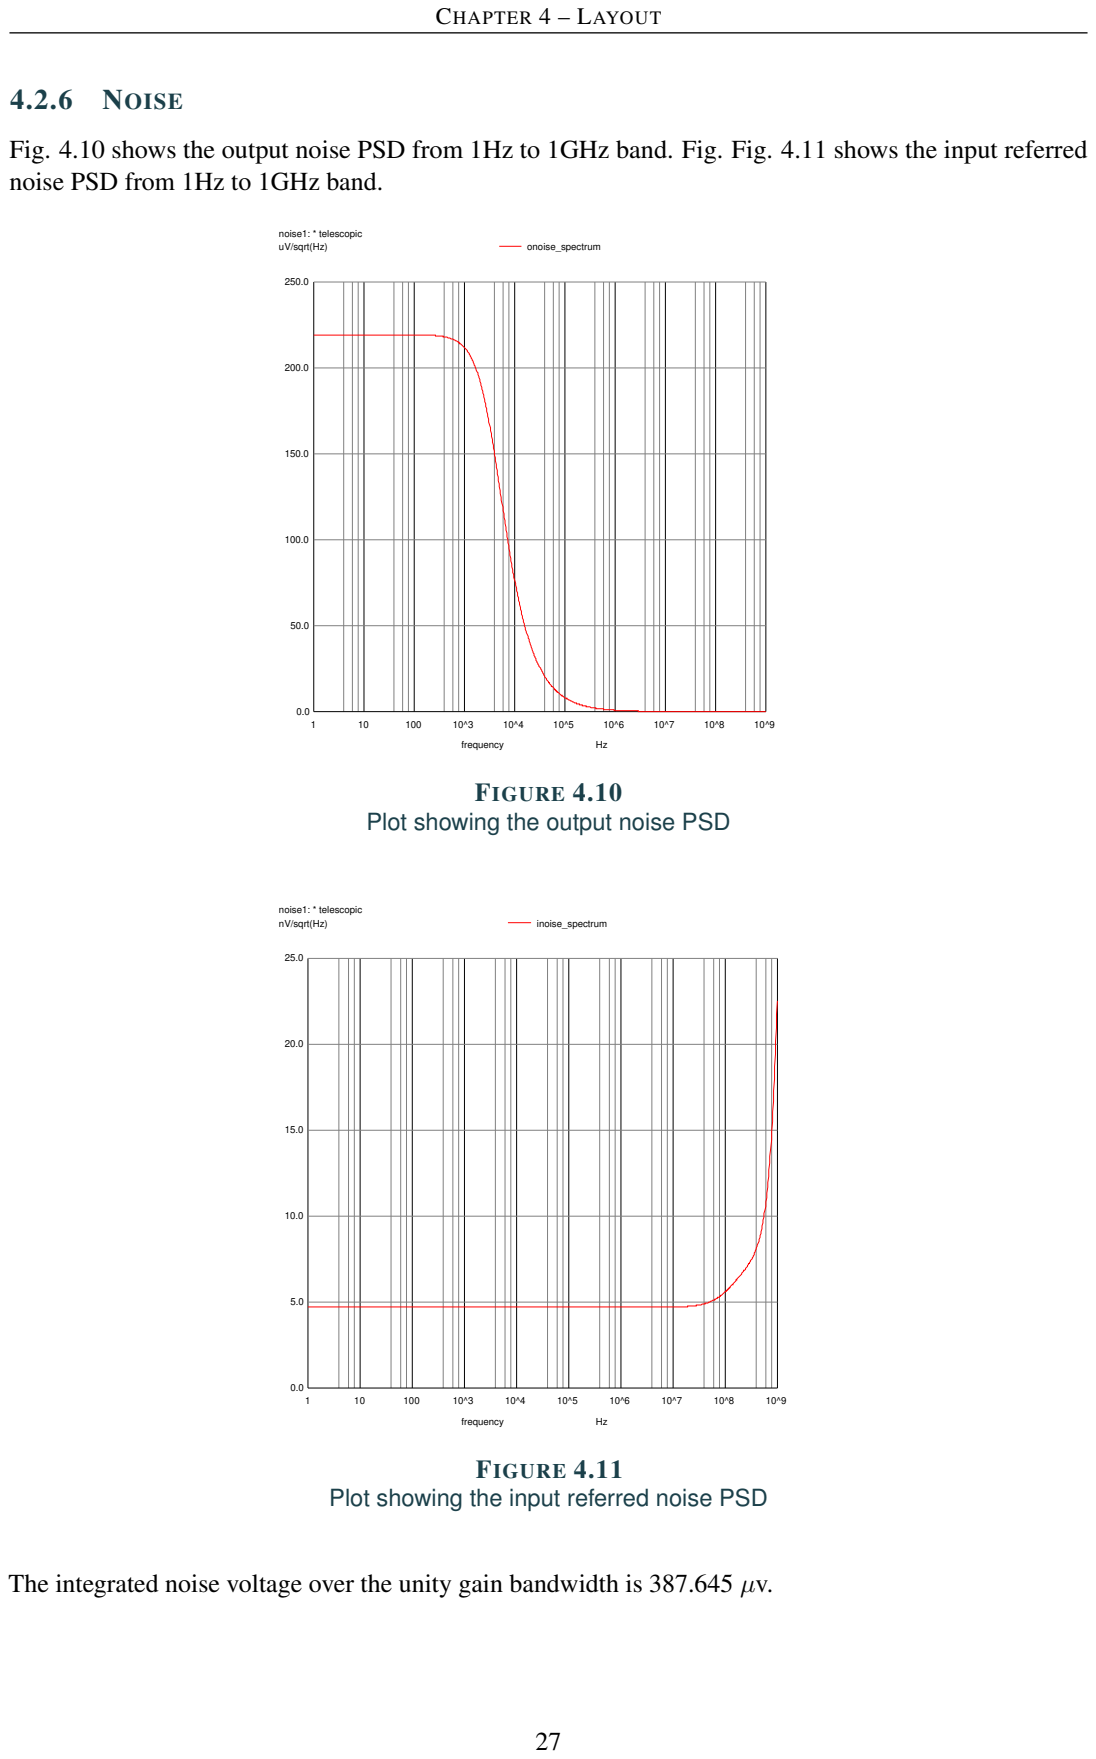
[picture p24: page 30]
CHAPTER 4 – LAYOUT; 4.2.6 NOISE; frequency; noise1: * telescopic; uV/sqrt(Hz); onoise_spectrum; FIGURE 4.10; nV/sqrt(Hz); inoise_spectrum; FIGURE 4.11

Fig. 4.10 shows the output noise PSD from 1Hz to 1GHz band. Fig. Fig. 4.11 shows the input referred
noise PSD from 1Hz to 1GHz band.

Plot showing the output noise PSD

Plot showing the input referred noise PSD

The integrated noise voltage over the unity gain bandwidth is 387.645 µv.

CHAPTER 4 – LAYOUT

### 4.2.7 CMRR

Common mode rejection ratio (CMRR) quantifies the ability of the device to reject common-mode signals. Fig. 4.12 shows the open loop CM gain of the OTA.

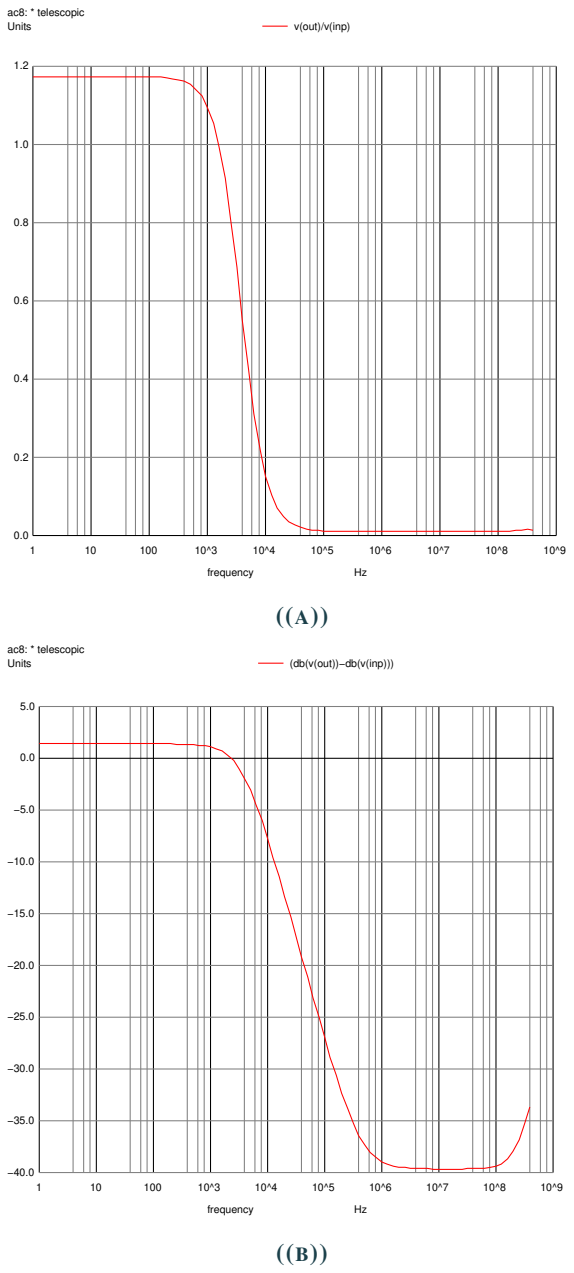
[picture p25: figure]
frequency; ac8: * telescopic; Units; v(out)/v(inp); (db(v(out))−db(v(inp)))

FIGURE 4.12
Common mode gains

The CM gain (ACM) of the OTA is found to be 0.98 V/V. The differential gain (Ad) of the device is 40017 V/V. Hence, the CMRR of the OTA is given by Ad
ACM

which is equal to 39752.1 which is equivalent to 91.98 dB.

CHAPTER 4 – LAYOUT

### 4.2.8 PSRR

The power supply rejection ratio (PSRR) is used to quantify the ability of the device to reject variations in power supply. The PSRR simulation is performed by adding a small signal component only on the voltage supply of the OTA. Fig. 4.13 shows the results obtained.

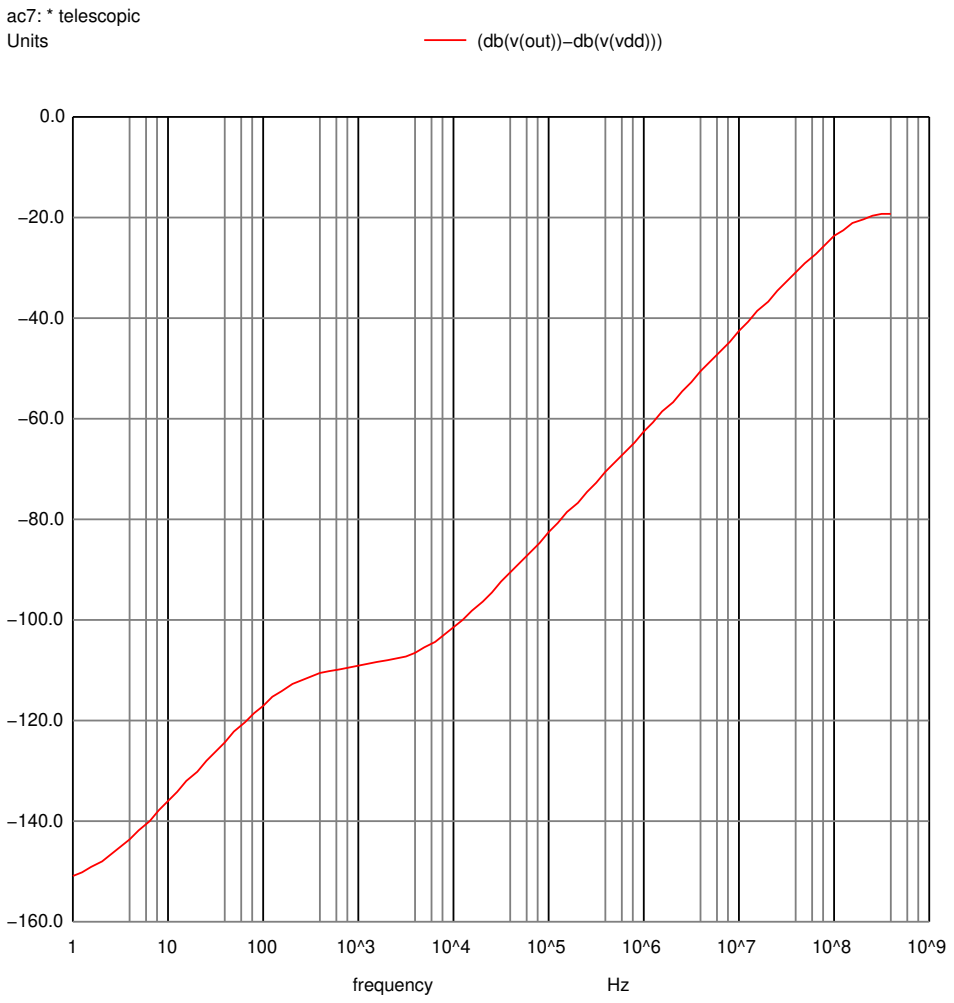
[picture p26: figure]
frequency; ac7: * telescopic; Units; (db(v(out))−db(v(vdd)))

FIGURE 4.13
Gain due to power supply

The PSRR of the OTA is -150.75 dB which means the OTA highly diminishes changes in supply voltage and hence, is resilient to variations in power supply.

CHAPTER 4 – LAYOUT

### 4.2.9 INPUT COMMON MODE RANGE

The input common mode voltage is sweeped in the unity gain configuration. Fig. 4.14 shows the results

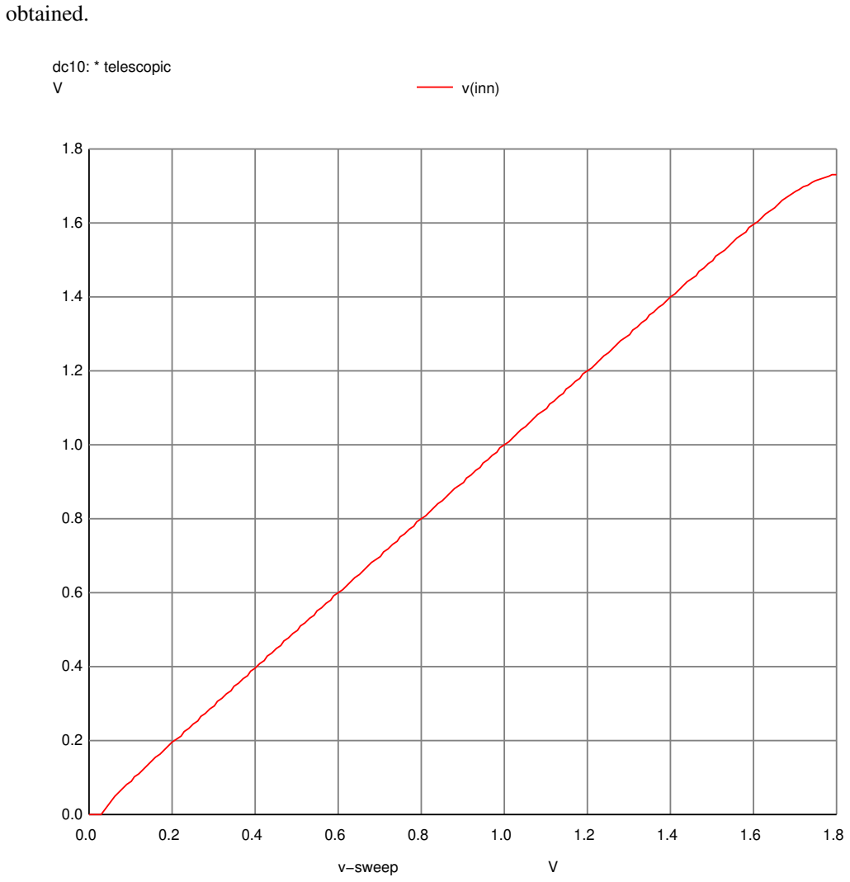
[picture p27: figure]
obtained.; v−sweep; dc10: * telescopic; v(inn)

FIGURE 4.14
Variation of output voltage with input common mode voltage

The maximum input common mode range is 0.4 V - 1.45 V.

CHAPTER 4 – LAYOUT

### 4.2.10 CLOSED LOOP GAIN

With the OTA in unity gain feedback mode, ac analysis is performed. Fig. 4.15 shows the results obtained.

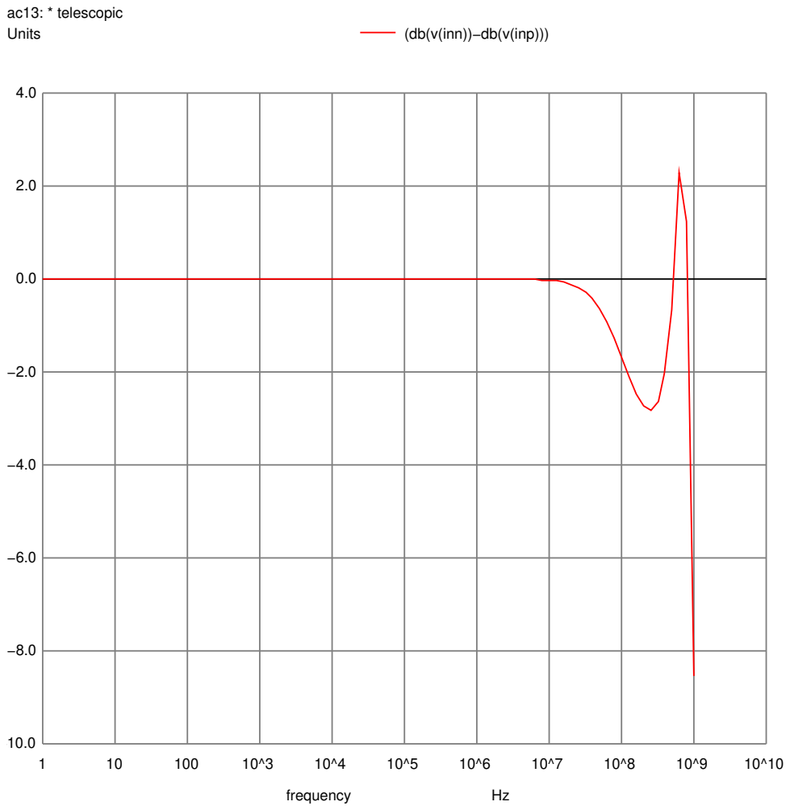
[picture p28: figure]
frequency; ac13: * telescopic; Units; (db(v(inn))−db(v(inp)))

FIGURE 4.15
Closed loop gain

The closed loop gain is 0 dB or 1 V/V with a -3dB frequency of 0.861 GHz.

CHAPTER 4 – LAYOUT

### 4.2.11 CLOSED LOOP TRANSIENT ANALYSIS

With the OTA in unity gain feedback mode, a sinusoidal signal of 10KHz frequency is applied for maximum signal swing at the output without distortion Fig. 4.16 shows the results obtained.

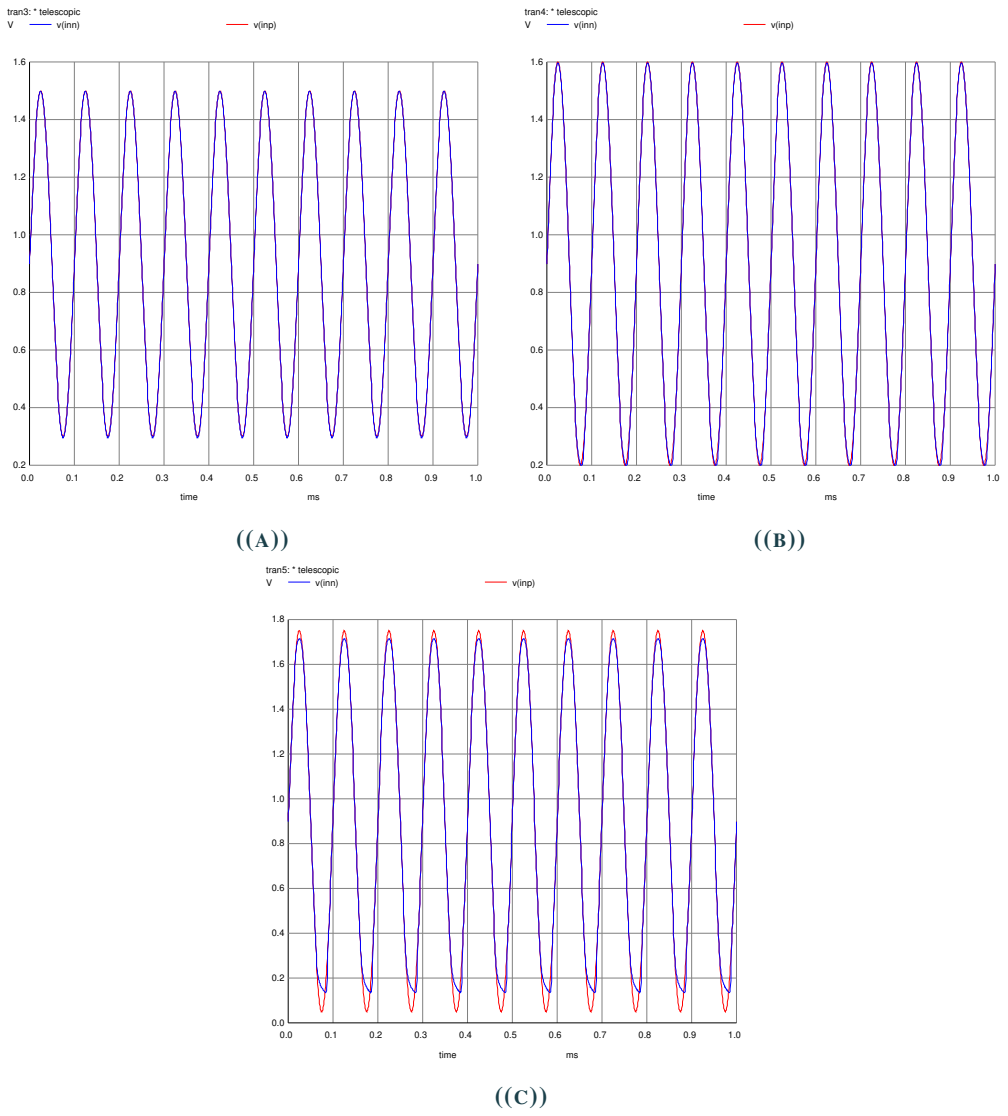
[picture p29: figure]
time; tran3: * telescopic; v(inn); v(inp); tran4: * telescopic; tran5: * telescopic

FIGURE 4.16
Closed loop transient analysis plots: (a) Output swing of 1.22 V, (b) Output swing of 1.4 V and (c) Output swing of 1.7 V

Output swing of 1.2 V can be obtained with THD less than 0.3% while a swing of 1.4 V increases the THD to 1.2%. Output swing of upto 1.7 V can be obtained with a THD of 5.5%.

### 4.2.12 POWER CONSUMPTION

The average value of current drawn by the OTA from supply in simulation is 580.116 µA and the total power consumption is 1.044 mW.

## CHAPTER 5

# DESIGN EXAMPLE

### 5.1 MULTIPLY-BY-TWO CIRCUIT

A multiply by 2 circuit can be constructed as shown in Fig. 5.1.

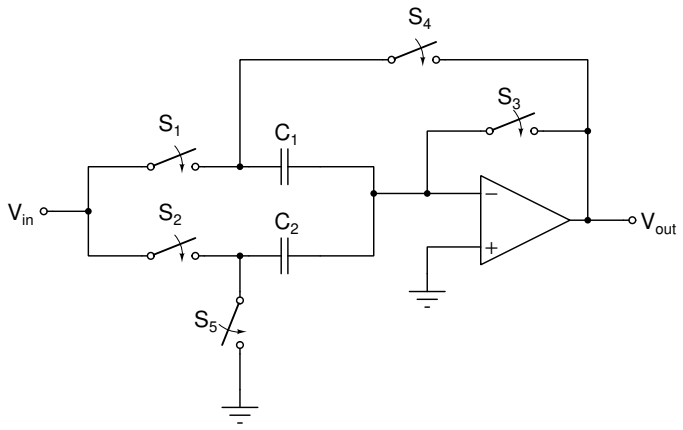
[picture p30: figure]
Vout; Vin

FIGURE 5.1
Multiply-by-2 structure

The switches are implemented using MOSFETs. The switching transistors and capacitors are selected such that sufficient precision and speed are ensured.

Table 5.1 shows the components and their respective sizing used in the circuit.

TABLE 5.1
Table showing design parameters of components used
Parameter | Used value
W µm ( ) L µm s | 10
C1, C2 (pF) | 1

CHAPTER 5 – DESIGN EXAMPLE

The ngspice netlist is as follows

* M u l t i p l y by 2
. i n c l u d e . . / TSMC_180nm . t x t

. param SUPPLY=1.8
. param LAMBDA=0.09 u
. param l e n g t h =0.36 u

. param width_1234 ={0.36*71 u} . param width_5678 ={0.36*160 u} . param width_910 ={0.36*142 u} . param width_11 ={0.36*157 u} . param width_12 ={0.36*79 u}

. param w i d t h _ s ={10u}
. param l e n g t h _ s ={1u}

. g l o b a l gnd vdd

Vdd | vdd | gnd | ’SUPPLY’
I r e f gnd r e f 400 u
Vb1 b1 gnd 1 . 4
Vb2 b2 gnd 0 . 7

v i n i n gnd 0 . 8

vs1 s1 gnd pwl (0 1 . 8 2 . 2 u 1 . 8 2 . 2 0 1 u 0 10u 0) vs2 s2 gnd pwl (0 1 . 8 4u 1 . 8 4 . 5 0 1 u 0 10u 0) vs3 s3 gnd pwl (0 1 . 8 2 . 2 u 1 . 8 2 . 2 0 1 u 0 10u 0) vs4 s4 gnd pwl (0 0 2 . 2 u 0 2 . 2 0 1 u 1 . 8 10u 1 . 8 ) vs5 s5 gnd pwl (0 0 2 . 8 u 0 2 . 8 0 1 u 1 . 8 10u 1 . 8 )

Cc d4 k 2p
Rs k o u t 1k
M1 | d1 | i n n | d9 | gnd | CMOSN | W={ width_1234 } | L={ l e n g t h }
+ AS={5* width_1234 *LAMBDA} PS={10*LAMBDA+2* width_1234 } AD={5* width_1234 *LAMBDA} PD={10*LAMBDA+2* width_1234 }
M2 | d2 | gnd | d9 | gnd | CMOSN | W={ width_1234 } | L={ l e n g t h }
+ AS={5* width_1234 *LAMBDA} PS={10*LAMBDA+2* width_1234 } AD={5* width_1234 *LAMBDA} PD={10*LAMBDA+2* width_1234 }
M3 | d3 | b1 | d1 | gnd | CMOSN | W={ width_1234 } | L={ l e n g t h }
+ AS={5* width_1234 *LAMBDA} PS={10*LAMBDA+2* width_1234 } AD={5* width_1234 *LAMBDA} PD={10*LAMBDA+2* width_1234 }
M4 | d4 | b1 | d2 | gnd | CMOSN | W={ width_1234 } | L={ l e n g t h }
+ AS={5* width_1234 *LAMBDA} PS={10*LAMBDA+2* width_1234 } AD={5* width_1234 *LAMBDA} PD={10*LAMBDA+2* width_1234 }
M5 | d3 | b2 | d5 | vdd | CMOSP | W={ width_5678 } | L={ l e n g t h }
+ AS={5* width_5678 *LAMBDA} PS={10*LAMBDA+2* width_5678 } AD={5* width_5678 *LAMBDA} PD={10*LAMBDA+2* width_5678 }
M6 | d4 | b2 | d6 | vdd | CMOSP | W={ width_5678 } | L={ l e n g t h }
+ AS={5* width_5678 *LAMBDA} PS={10*LAMBDA+2* width_5678 } AD={5* width_5678 *LAMBDA} PD={10*LAMBDA+2* width_5678 }
M7 | d5 | d3 | vdd | vdd | CMOSP | W={ width_5678 } | L={ l e n g t h }
+ AS={5* width_5678 *LAMBDA} PS={10*LAMBDA+2* width_5678 } AD={5* width_5678 *LAMBDA} PD={10*LAMBDA+2* width_5678 }
M8 | d6 | d3 | vdd | vdd | CMOSP | W={ width_5678 } | L={ l e n g t h }
+ AS={5* width_5678 *LAMBDA} PS={10*LAMBDA+2* width_5678 } AD={5* width_5678 *LAMBDA} PD={10*LAMBDA+2* width_5678 }
M9 | d9 | r e f | gnd | gnd | CMOSN | W={ width_910 } | L={ l e n g t h }
+ AS={5* width_910 *LAMBDA} PS={10*LAMBDA+2* width_910 } AD={5* width_910 *LAMBDA} PD={10*LAMBDA+2* width_910 }
M10 | r e f | r e f | gnd | gnd | CMOSN | W={ width_910 } | L={ l e n g t h }
+ AS={5* width_910 *LAMBDA} PS={10*LAMBDA+2* width_910 } AD={5* width_910 *LAMBDA} PD={10*LAMBDA+2* width_910 }
M11 | o u t | d4 | vdd | vdd | CMOSP | W={ width_11 } | L={ l e n g t h }
+ AS={5* width_11 *LAMBDA} PS={10*LAMBDA+2* width_11 } AD={5* width_11 *LAMBDA} PD={10*LAMBDA+2* width_11 }
M12 | o u t | r e f | gnd | gnd | CMOSN | W={ width_12 } | L={ l e n g t h }
+ AS={5* width_12 *LAMBDA} PS={10*LAMBDA+2* width_12 } AD={5* width_12 *LAMBDA} PD={10*LAMBDA+2* width_12 }

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

. t r a n 0 . 1 u 10u

. c o n t r o l
run

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

CHAPTER 5 – DESIGN EXAMPLE

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

* p l o t v ( o u t ) / ( v ( i n p ) − v ( i n n ) )

. endc

### 5.2 TRANSIMPEDANCE AMPLIFIER (TIA)

A transimpedance amplifier takes current input and converts current into voltage. For a gain of 500K ohm, we connect a feedback resistor of value 500k ohm as shown in Fig. 5.2.

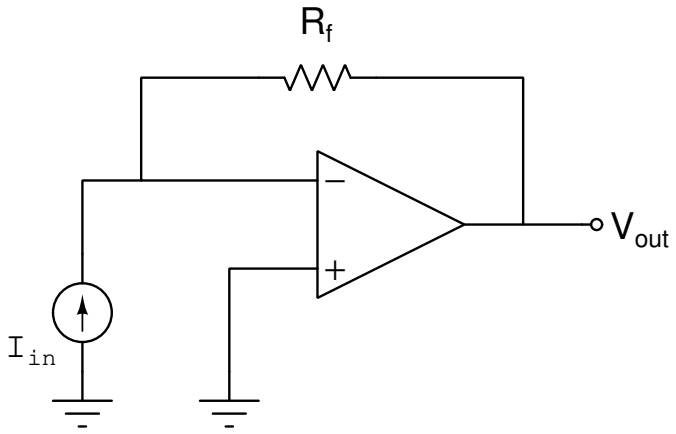
[picture p31: figure]
Vout; Iin

FIGURE 5.2
Transimpedance amplifier using OTA

The transimpedance gain of the circuit is given by Eq. (5.1).

Transimpedance gain =

∆Vout

∆Iin

(5.1)

where ∆Vout is the peak to peak output voltage value and ∆Iin is the peak to peak input current value.

The following lines are added to the netlist to add the feedback resistor and the input current.

Rf o u t i n n 500 k

I i n gnd i n n dc 1u ac 2u s i n (1 u 2u 10k 0 0 0)

An input current with AC amplitude equal to 0.5 µA is given to the TIA circuit. Fig. 5.3 shows the voltage output obtained.

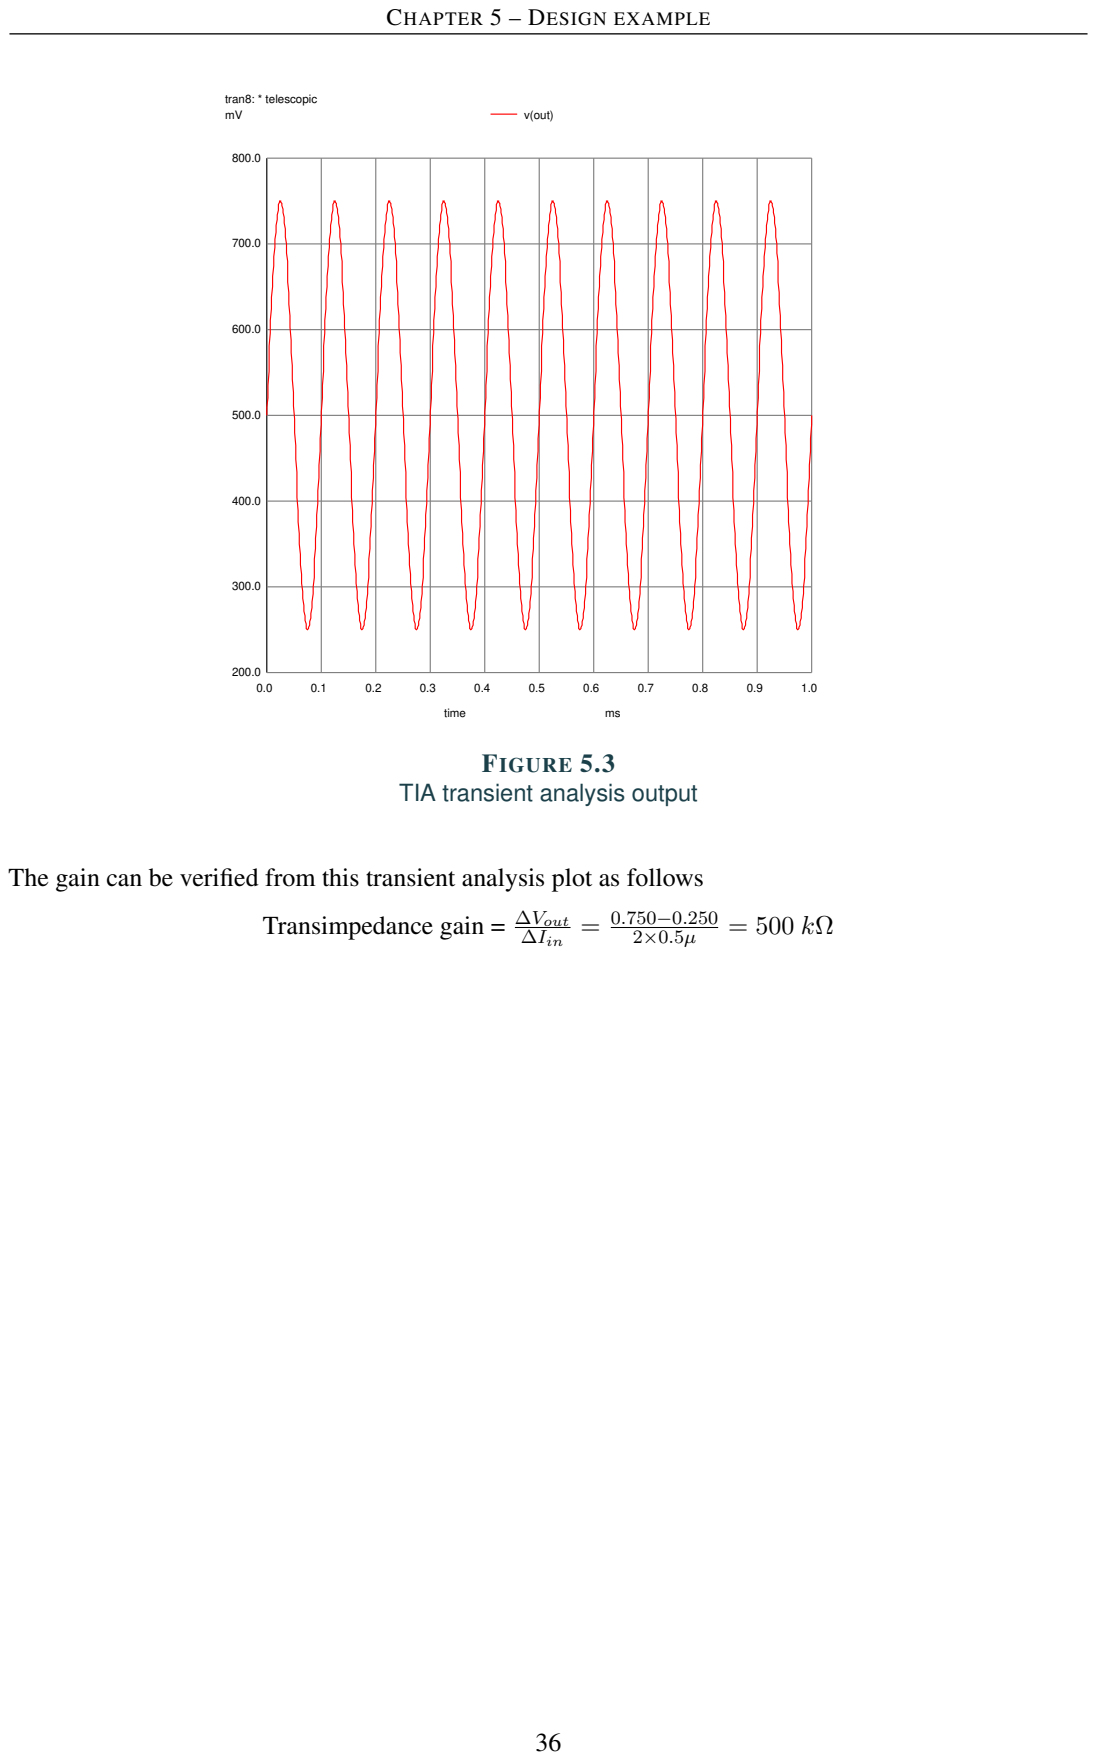
[picture p32: page 39]
time; tran8: * telescopic; v(out); FIGURE 5.3; ∆Iin

CHAPTER 5 – DESIGN EXAMPLE

TIA transient analysis output

The gain can be verified from this transient analysis plot as follows

Transimpedance gain = ∆Vout

## CHAPTER 6

# RESULTS

### 6.1 TABULATION AND COMPARISON

Table 6.2 summarizes the schematic and post-layout simulation results compared to given requirements.

TABLE 6.1
Table summarizing opamp performance
Specification | Requirement | Schematic | Layout
DC gain (dB) | ≥80 | 93.68 | 93.38
Unity gain frequency (MHz) | ≥10 | 275.305 | 214.26
Phase margin (◦ ) | ≥65 | 68 | 65
ICMR (V) | - | 0.4 - 1.45 | 0.4 - 1.45
CMRR (dB) | - | 92.22 | 91.98
PSRR (dB) | - | 151.8 | 150.75
Slew rate (V/µs) | ≥100 | 179.50 | 184.07
Settling time (ns) | - | 12.748 | 12.777
Systematic offset (µV) | - | 3.45 | 4.3
Output swing (Vpp) | ≥1 | 1.6 | 1.6
RMS thermal noise (nV/√ Hz) | 10 | 4.69 | 4.70
Power (mW) | - | 1.024 | 1.044

Table 6.2 presents the comparison of proposed OTA specifications with related works.

CHAPTER 6 – RESULTS

TABLE 6.2
Table showing comparison of proposed opamp with related works
Specification | [1] | [2] | [3] | [4] | [5] | Schematic | Layout
Technology (nm) | 45 | 350 | - | 40 | 180 | 180 | 180
VDD (V) | 1 | 3.3 | 5 | 1.1 | 1.8 | 1.8 | 1.8
DC gain (dB) | 100 | 78.21 | 80 | 49 | 74 | 93.68 | 93.38
Unity gain frequency (MHz) | 25 | 5.81 | 3.8 | 3600 | 160 | 275.305 | 214.26
Phase margin (◦) | 50 | 64 | 70 | 65 | 75 | 68 | 65
ICMR (V) | - | 2.15 - (-1.98) | 4 - (-2.5) | - | - | 0.4 - 1.45 | 0.4 - 1.45
CMRR (dB) | - | 89.05 | 74 | - | - | 92.22 | 91.98
PSRR (dB) | - | 117.73 | 84.5 | - | - | 151.8 | 150.75
Slew rate (V/µs) | - | 5.58 | - | 1250 | 26.7 | 179.50 | 184.07
Power (mW) | 0.012 | 0.284 | - | 3.3 | 0.477 | 1.024 | 1.044

### 6.2 RESULTS

The proposed OTA design implemented in 180nm CMOS technology achieves high gain 93.38 dB. It consumes 1.044 mW of power on a 1.8 V supply. The amplifier has a phase margin of 65◦ at a unity gain bandwidth 214.26 MHz. The proposed structure is also able to achieve high slew rates of >179 V/µs. The OTA is also resilient to variations in common mode voltage and supply voltage due to its high CMRR and PSRR. It is seen that the proposed design offers high gain and sufficiently high slew rate without compromising much on phase margin and the gain bandwidth as compared to related works.

38

# BIBLIOGRAPHY

[1] R. Nagulapalli, S. Zourob, K. Hayatleh, N. Yassine, S. Barker and A. Venkatareddy, "A compact high gain opamp for Bio-medical appli-cations in 45nm CMOStechnology," 2017 2nd IEEE International Conference on Recent Trends in Electronics, Information & Communication Technology (RTEICT), 2017, pp. 231-235.
[2] S. K. Rajput and B. K. Hemant, "Two-stage high gain low power OpAmp with current buffer compensation," 2013 IEEE Global High Tech Congress on Electronics, 2013, pp. 121-124.
[3] B. K. Ahuja, "An improved frequency compensation technique for CMOS operational amplifiers," in IEEE Journal of Solid-State Circuits, vol. 18, no. 6, pp. 629-633, Dec. 1983, doi: 10.1109/JSSC.1983.1052012.
[4] M. H. Naderi, S. Prakash and J. Silva-Martinez, "Operational Transconductance Amplifier With Class-B Slew-Rate Boosting for Fast High-Performance Switched-Capacitor Circuits," in IEEE Transactions on Circuits and Systems I: Regular Papers, vol. 65, no. 11, pp. 3769-3779, Nov. 2018.
[5] A. P. Perez, Y. B. Nithin Kumar, E. Bonizzoni and F. Maloberti, "Slew-rate and gain enhancement in two stage operational amplifiers," 2009 IEEE International Symposium on Circuits and Systems (ISCAS), 2009, pp. 2485-2488.
[6] A. Gerlach, J. Scheible, T. Rosahl and F. Eitrich, "A generic topology selection method for analog circuits demonstrated on the OTA example," 2015 11th Conference on Ph.D. Research in Microelectronics and Electronics (PRIME), 2015, pp. 77-80.
[7] P. E. Allen and D. R. Holberg, “CMOS Analog Circuit Design,” Oxford University Press, New York, 2004.
[8] B. Razavi, “Design of Analog Cmos Integrated Circuits,” McGraw-Hill, Boston, MA, 2001.
[9] S. N. S. Baharudin, A. B. Jambek and R. C. Ismail, "Design and analysis of a two-stage OTA for sensor interface circuit," 2014 IEEE Symposium on Computer Applications and Industrial Electronics (ISCAIE), 2014, pp. 88-92.
[10] A. Shukla1, A. Girolkar, J. Verma, "Review of folded cascode & telescopic op-amp", International Journal of Emerging Technologies and Innovative Research, ISSN:2349-5162, Vol.4, Issue 5, page no.50-56, May-2017.
